CamilV/FEEG2001_QuadCopter/Code/Autopilot flight.png

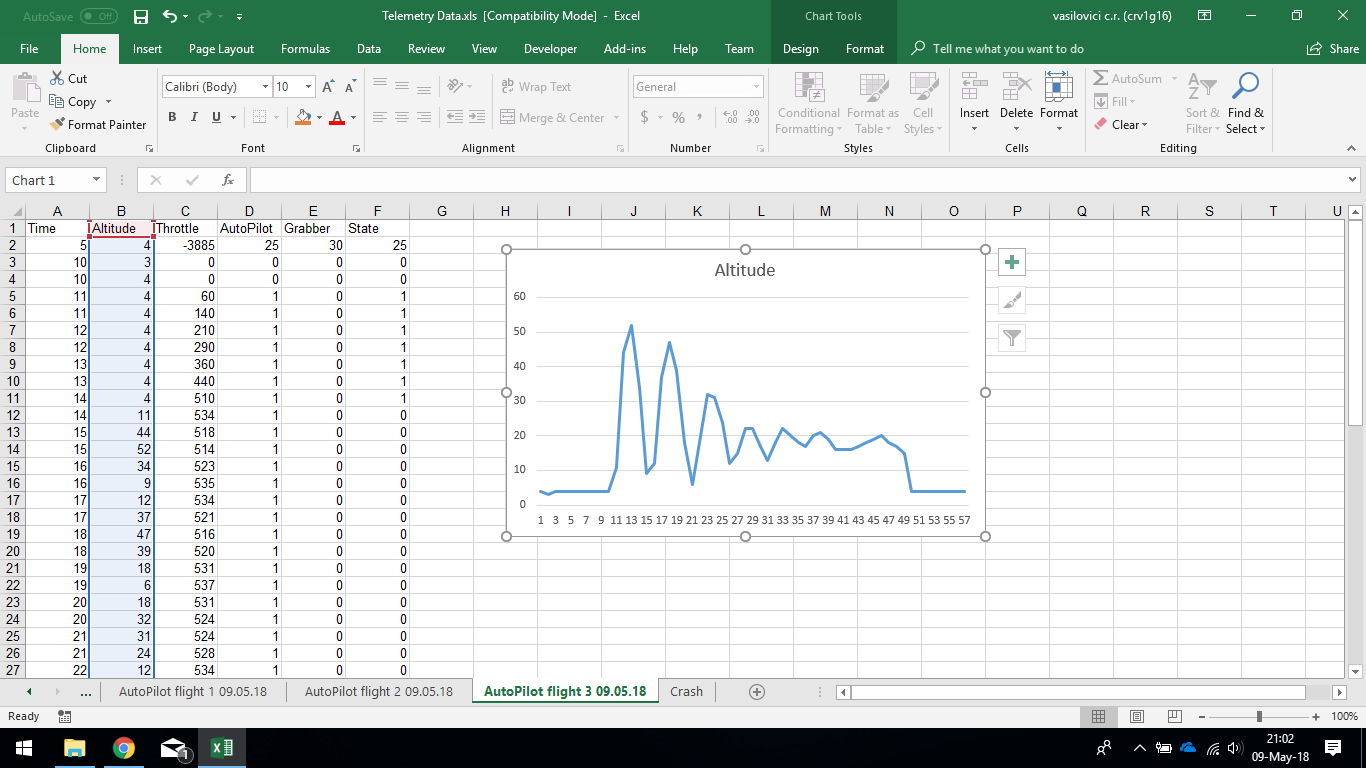
Code/Autopilot flight.png
