CamilV/FEEG2001_QuadCopter/Electronics/ArduinoBoard v3/base board v3_CopperStripes Board.jpg

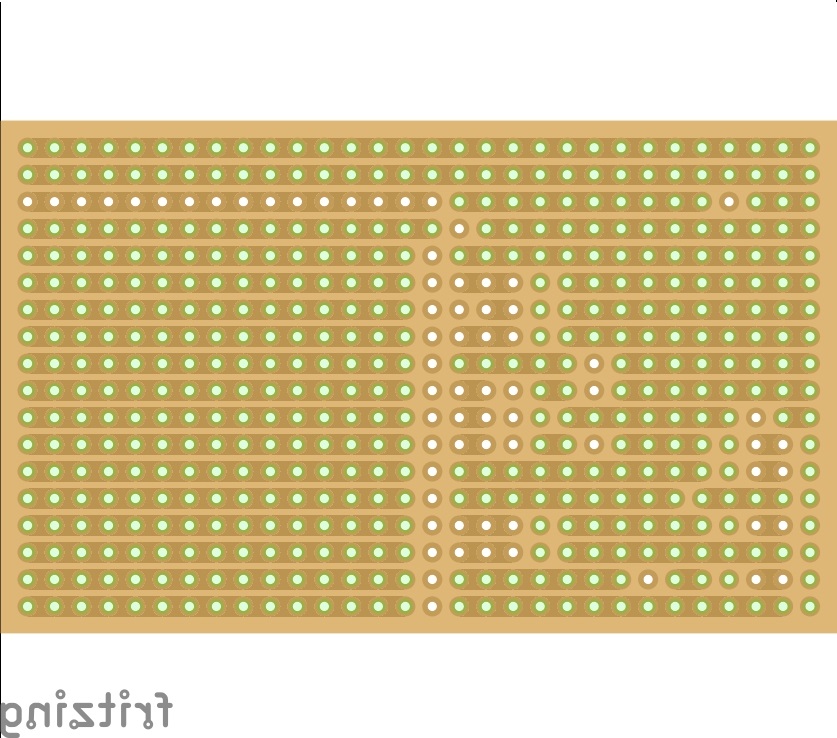
Electronics/ArduinoBoard v3/base board v3_CopperStripes Board.jpg
