CamilV/FEEG2001_QuadCopter/Report- Final/1.png

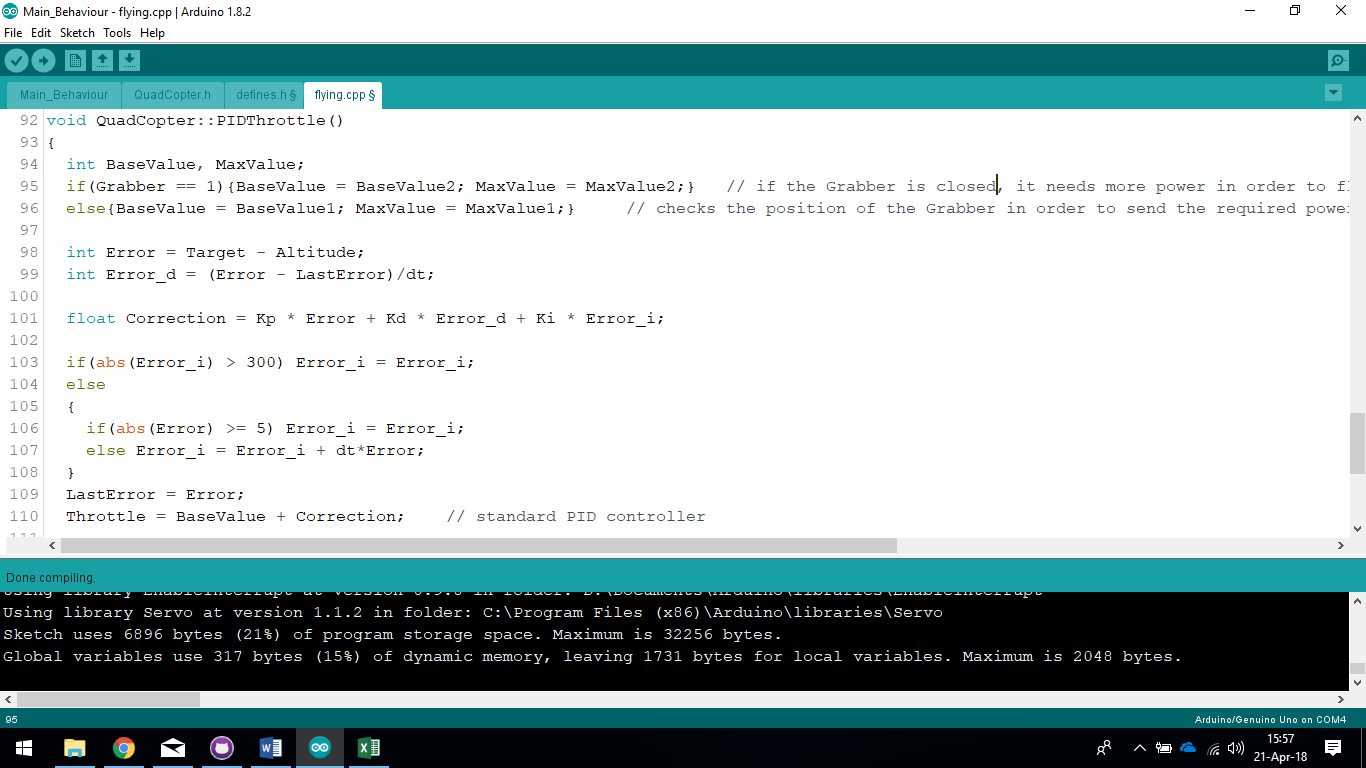
Report- Final/1.png
