CamilV/FEEG2001_QuadCopter/Report- Final/2.png

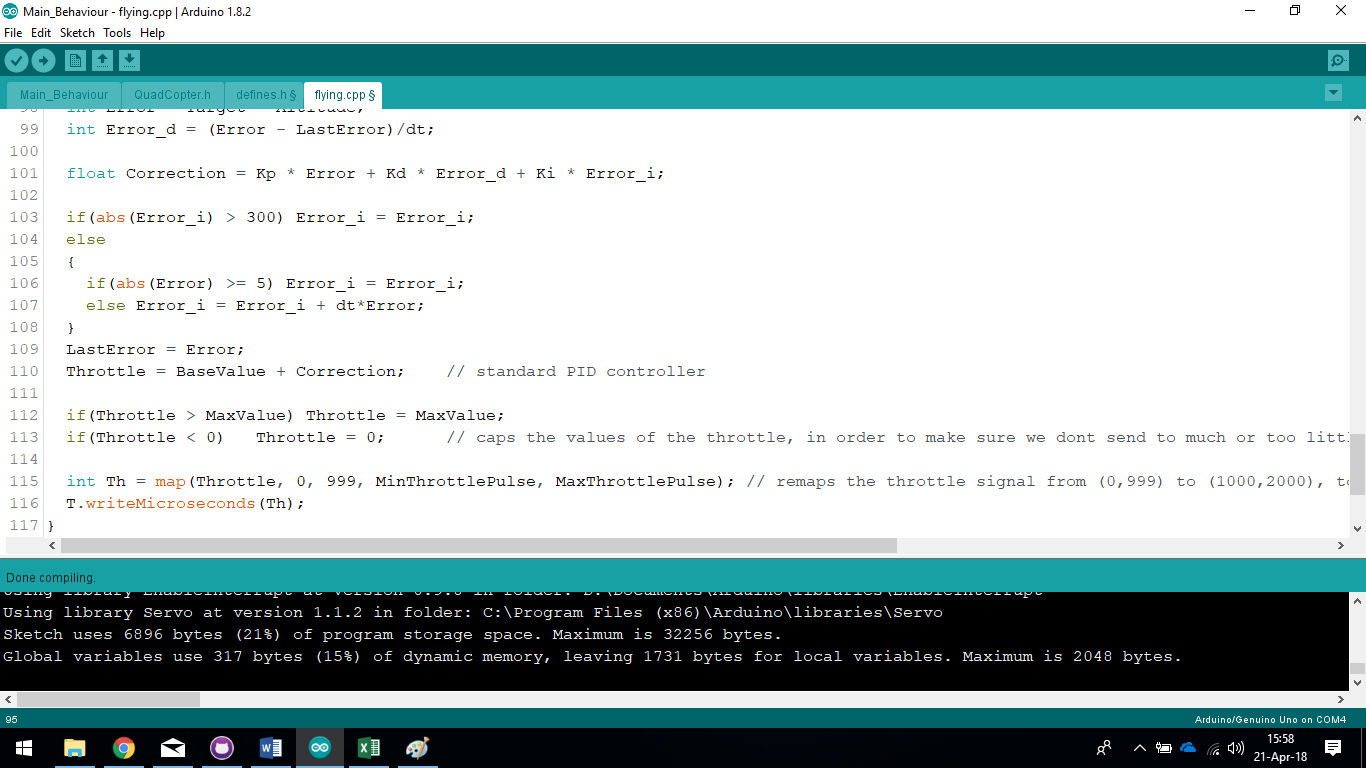
Report- Final/2.png
