CamilV/FEEG2001_QuadCopter/Report- Final/11.png

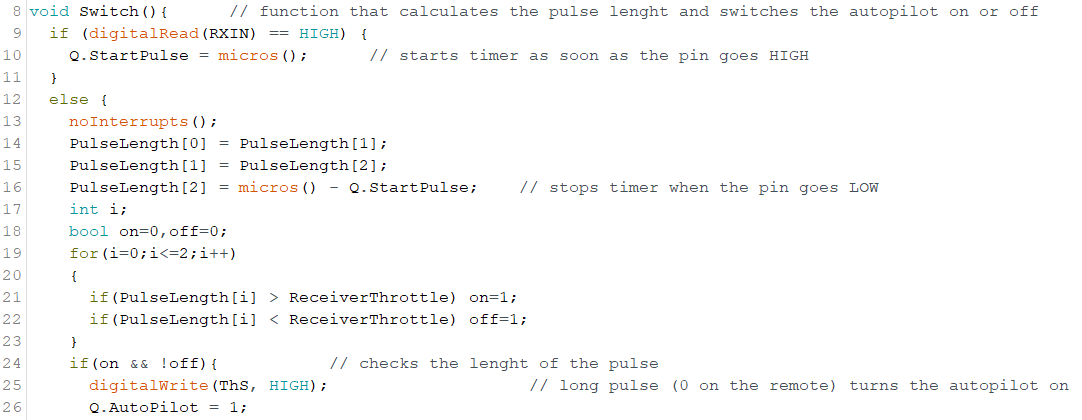
Report- Final/11.png
