CamilV/FEEG2001_QuadCopter/Report- Final/22.png

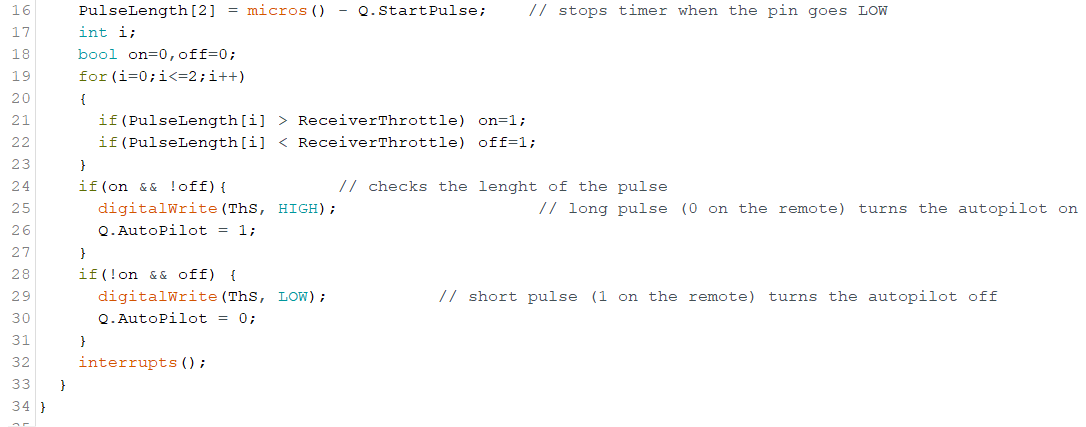
Report- Final/22.png
