CamilV/FEEG2001_QuadCopter/Report- Final/code 2.png

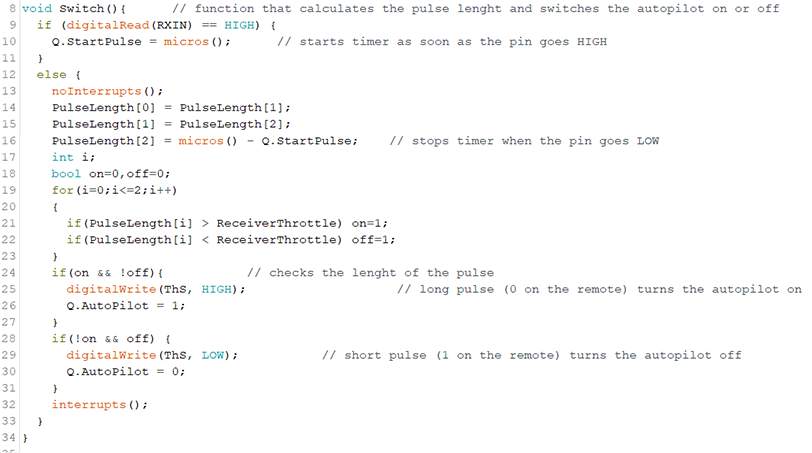
Report- Final/code 2.png
