CamilV/FEEG2001_QuadCopter/Report - Week 5/Mass quadcopter.ods

Component | Mass [Kg] | Number | Total mass [Kg] | Mass Constraint | Total
Main frame (mdf) | 0.0725 | 1 | 0.0725 | 0.75 | 0.6301
Arduino + shield | 0.0248 | 1 | 0.0248
Power distibution Board | 0.0122 | 1 | 0.0122
Flight controller board | 0.0081 | 1 | 0.0081
Battery | 0.168 | 1 | 0.168
Receiver | 0.005 | 1 | 0.005
Motor | 0.03 | 4 | 0.12
Propeller | 0.012 | 4 | 0.048
Speed controller | 0.007 | 4 | 0.028
Ultrasonic range finder | 0.015 | 1 | 0.015
Li-po bag | 0.075 | 1 | 0.075
Bullet connectors | 0.028 | 1 | 0.028
Servo | 0.0137 | 1 | 0.0137
M3 20mm Bolt | 1.3 |  | 0
M3 15mm Bolt | 1 |  | 0
10 x M3 Nut | 3.3 |  | 0
Landing Gear | 0.00095 | 4 | 0.0038
Hinges | 0.002 | 4 | 0.008
