CamilV/FEEG2001_QuadCopter/Solidworks Files/3 mm/Main Plate.SLDPRT

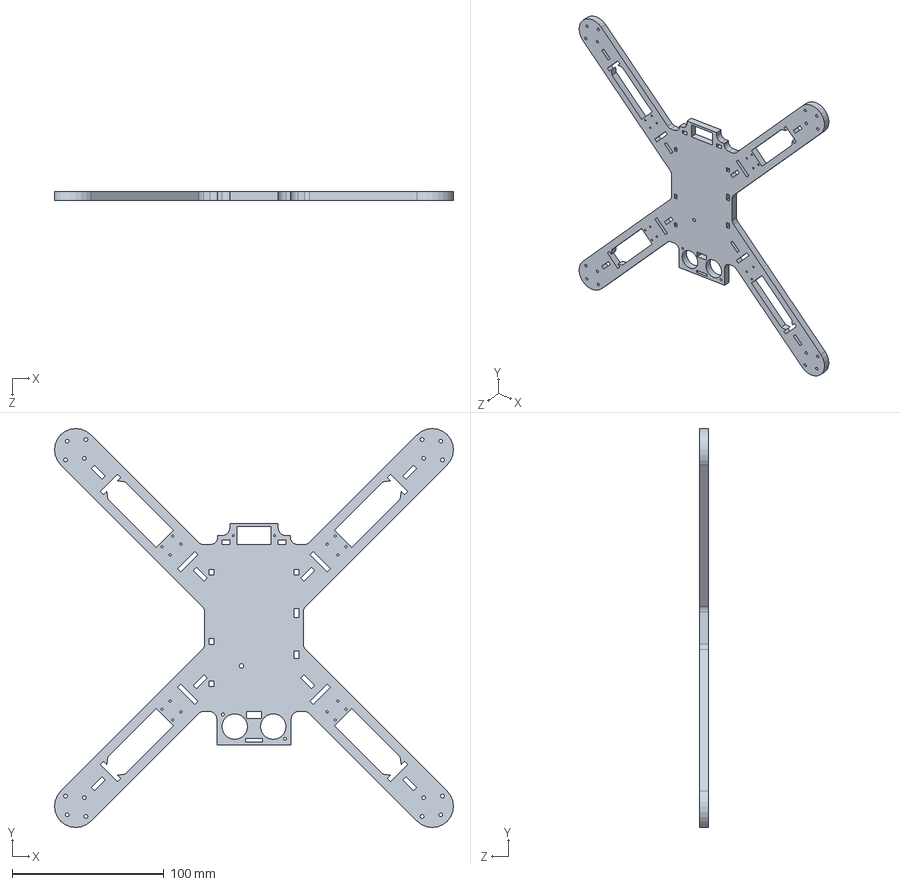
[picture p20: CAD file, 2018-05-09]
Solidworks Files/3 mm/Main Plate.SLDPRT
263.0 x 263.0 x 6.00 mm
