CamilV/FEEG2001_QuadCopter/Solidworks Files/3 mm/Servo Mini SG90/SG60 Servo.SLDASM

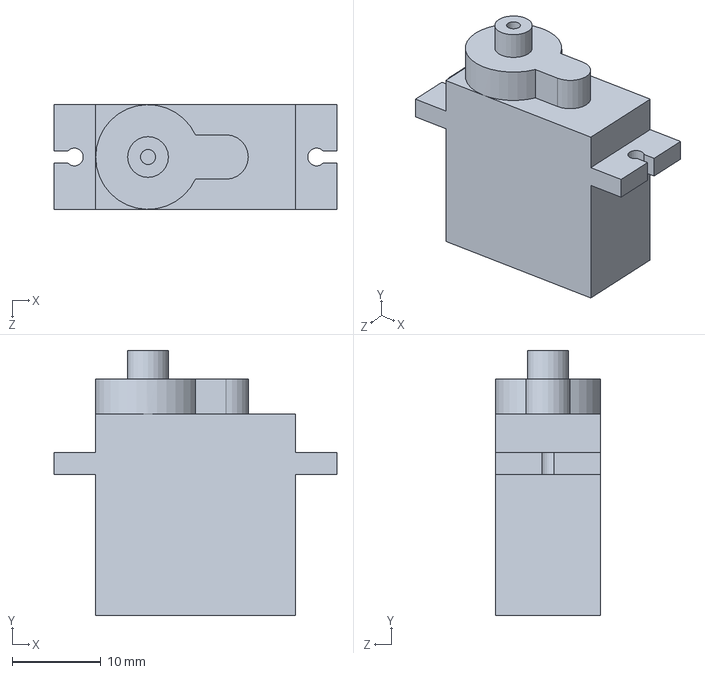
[picture p21: CAD file, 2018-02-15]
Solidworks Files/3 mm/Servo Mini SG90/SG60 Servo.SLDASM
31.9 x 29.9 x 11.8 mm
