CamilV/FEEG2001_QuadCopter/Solidworks Files/3 mm/Assem_Drone.SLDASM

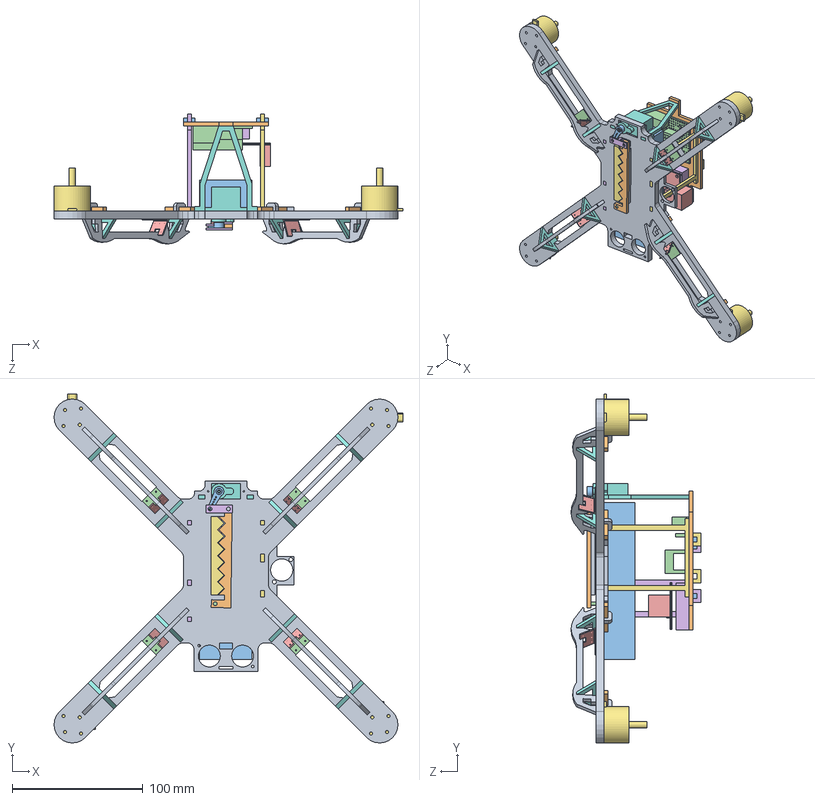
[picture p22: CAD file, 2018-05-09]
Solidworks Files/3 mm/Assem_Drone.SLDASM
266.9 x 266.9 x 99.2 mm
Main Plate
Secondary plate
Battery
arduino-and-shield (1)
PDB_MATEK
Naze32
DYS-SE2205 x 4
Servo
moving top
Moving Bottm
Horn Servo
Pivot
fixed top
Coupler - Copy
fixed bottom
triangular strut x 8
under-strut v2 x 4
pin x 8
pin short x 3
Copy of Part3 x 4
Long Side
Short Side
Back Side
max support
