CamilV/FEEG2001_QuadCopter/Main Plate.SLDPRT

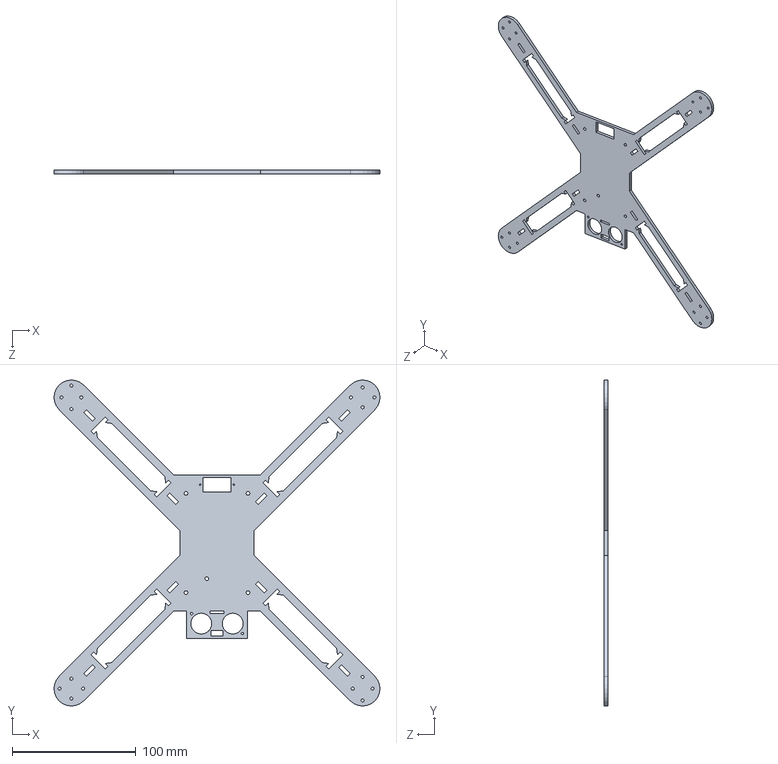
[picture p23: CAD file, 2018-02-19]
Main Plate.SLDPRT
263.0 x 263.0 x 3.00 mm
