CamilV/FEEG2001_QuadCopter/Solidworks Files/final cut/Main Plate.DXF

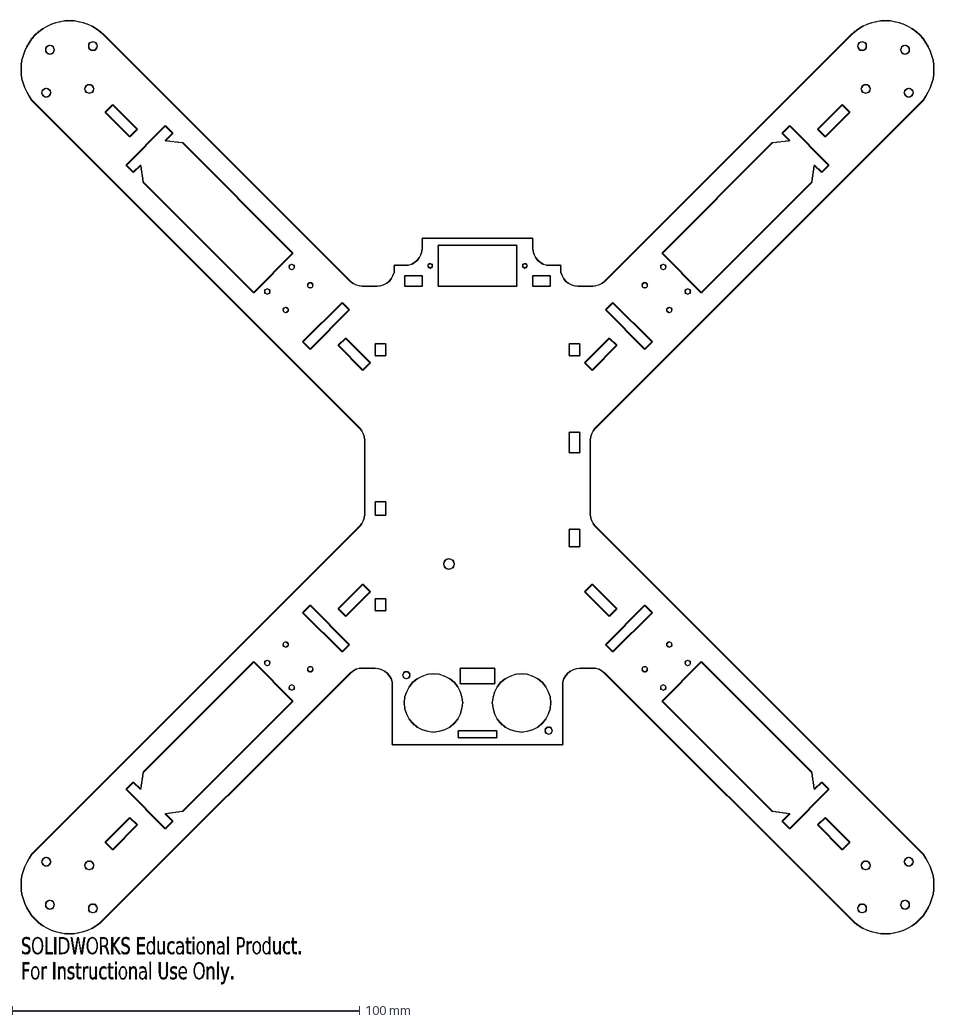
[picture p24: CAD file, 2018-05-09]
Solidworks Files/final cut/Main Plate.DXF
SOLIDWORKS Educational Product.
For Instructional Use Only.
