CamilV/FEEG2001_QuadCopter/SolidWorks Models/Grabber/Assem1.SLDASM

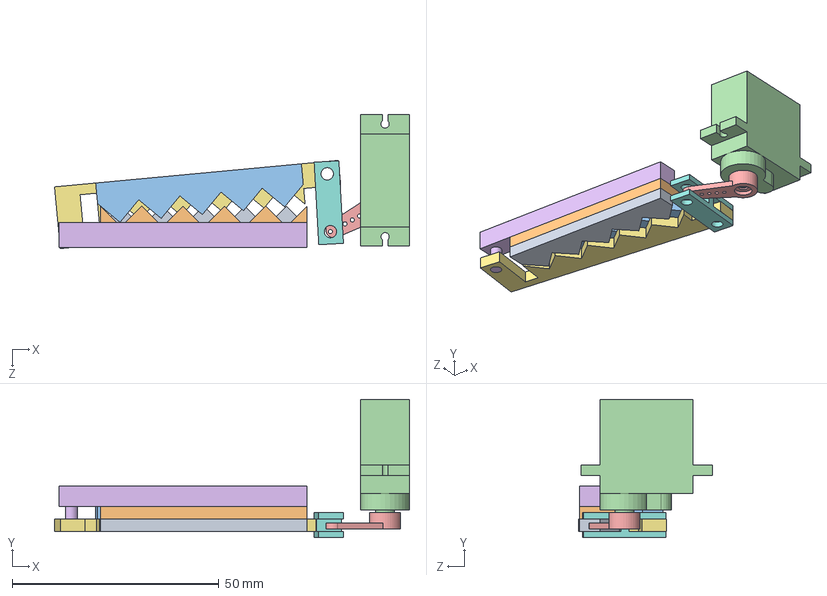
[picture p25: CAD file, 2018-02-12]
SolidWorks Models/Grabber/Assem1.SLDASM
85.9 x 33.4 x 32.5 mm
fixed bottom
fixed top
moving top
Servo
Horn Servo
holder(just so the mates can exist)
Moving Bottm
Coupler
