CamilV/FEEG2001_QuadCopter/Solidworks Files/4.5 mm/Main Plate.SLDPRT

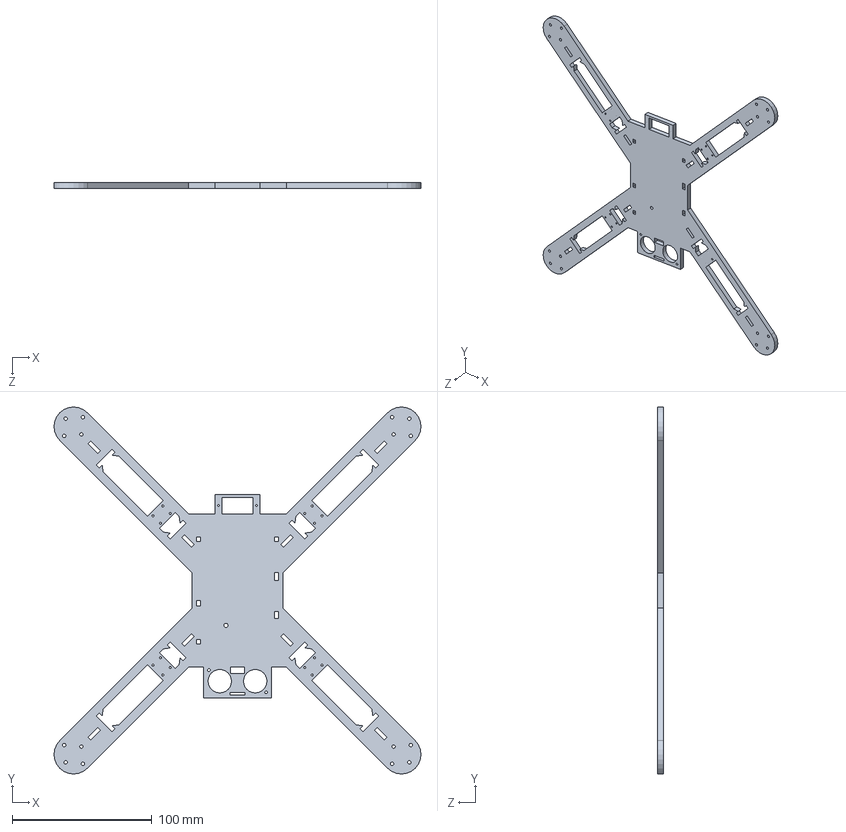
[picture p26: CAD file, 2018-03-05]
Solidworks Files/4.5 mm/Main Plate.SLDPRT
263.0 x 263.0 x 4.50 mm
