CamilV/FEEG2001_QuadCopter/Solidworks Files/3 mm/SolidWorks Models/Naze32.SLDPRT

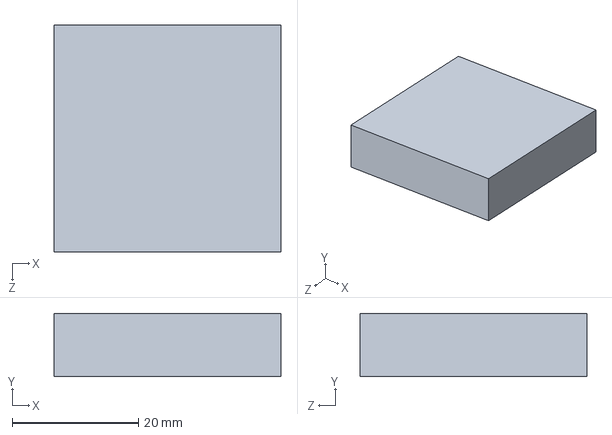
[picture p27: CAD file, 2018-02-15]
Solidworks Files/3 mm/SolidWorks Models/Naze32.SLDPRT
36.0 x 10.0 x 36.0 mm
