CamilV/FEEG2001_QuadCopter/Solidworks Files/final cut/Back Side.DXF

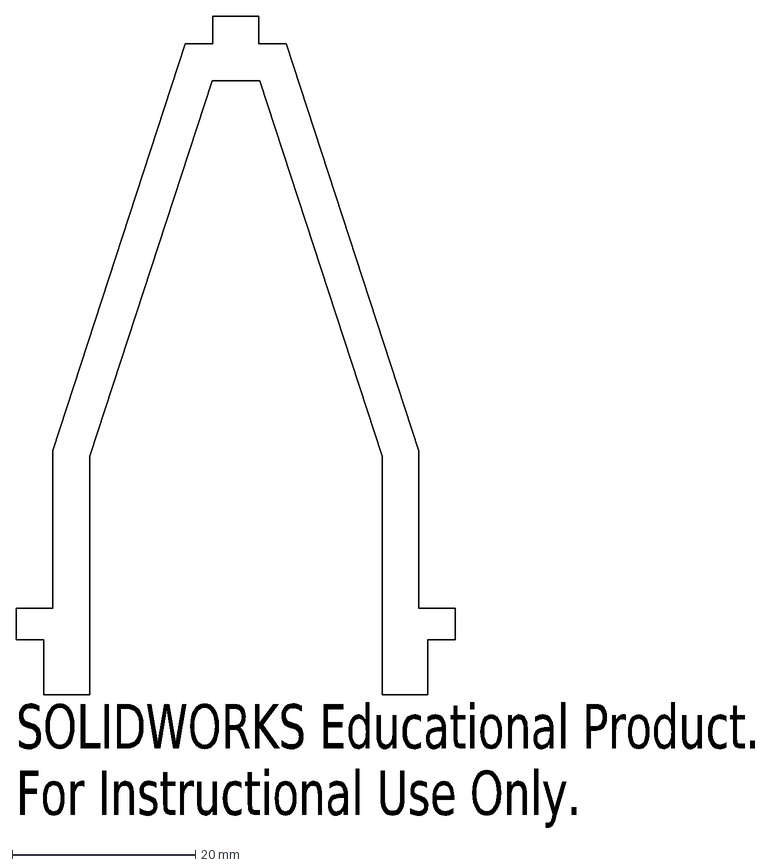
[picture p29: CAD file, 2018-05-09]
Solidworks Files/final cut/Back Side.DXF
SOLIDWORKS Educational Product.
For Instructional Use Only.
