CamilV/FEEG2001_QuadCopter/SolidWorks Models/Coupler-Copy.sldprt

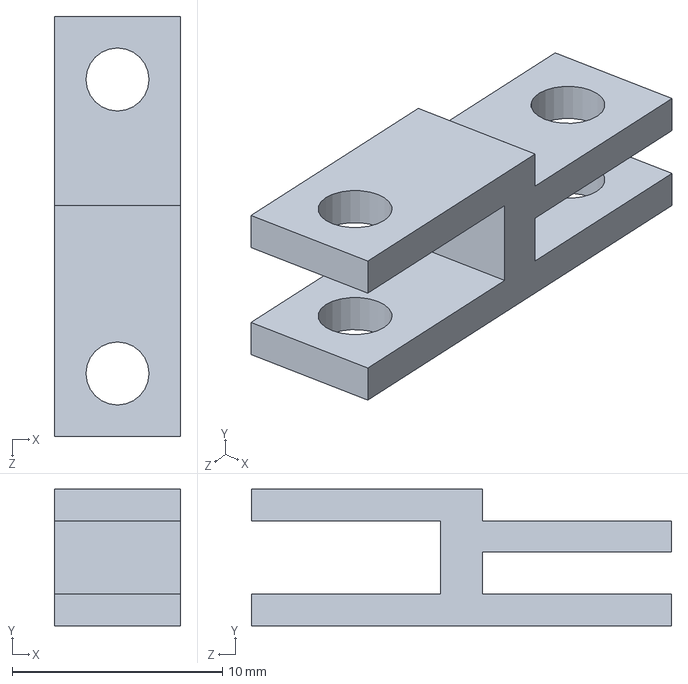
[picture p30: CAD file, 2018-02-14]
SolidWorks Models/Coupler-Copy.sldprt
6.00 x 6.50 x 20.0 mm
