CamilV/FEEG2001_QuadCopter/under-strut v2.sldprt

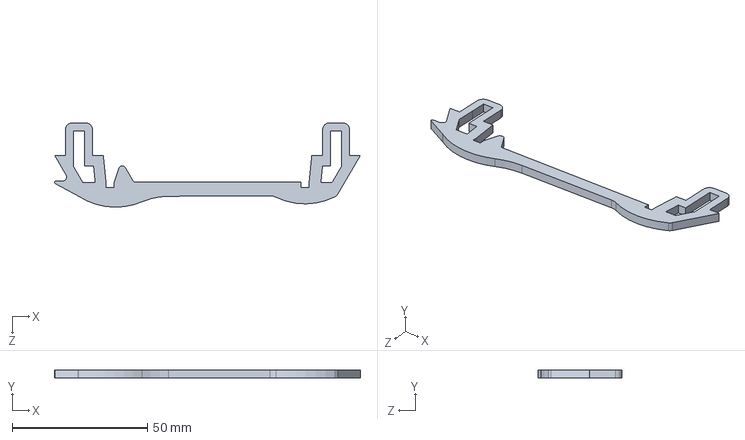
[picture p31: CAD file, 2018-05-06]
under-strut v2.sldprt
113.0 x 3.00 x 31.2 mm
