CamilV/FEEG2001_QuadCopter/Solidworks Files/3 mm/SolidWorks Models/Arduino Uno.SLDPRT

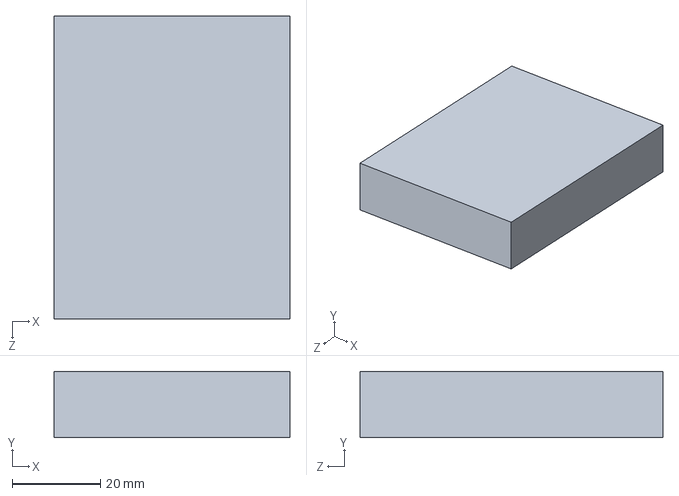
[picture p32: CAD file, 2018-02-15]
Solidworks Files/3 mm/SolidWorks Models/Arduino Uno.SLDPRT
53.4 x 15.0 x 68.6 mm
