CamilV/FEEG2001_QuadCopter/Solidworks Files/4.5 mm/SolidWorks Models/AfroESC 30.SLDPRT

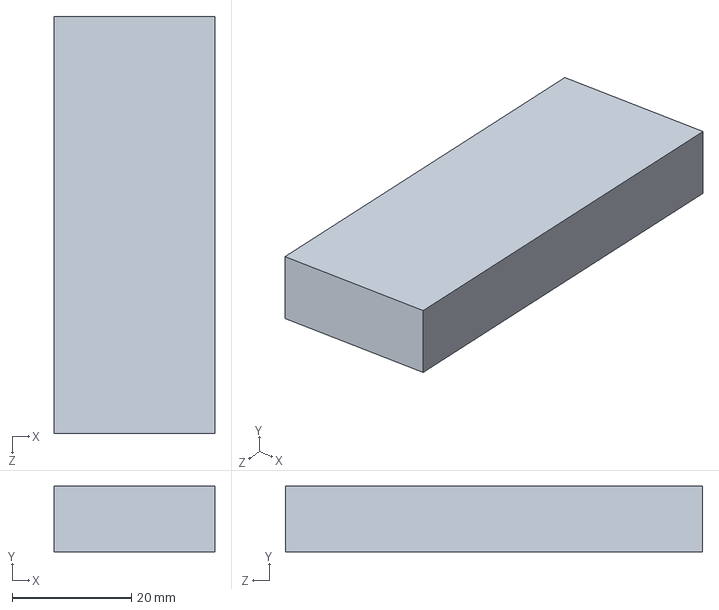
[picture p33: CAD file, 2018-02-15]
Solidworks Files/4.5 mm/SolidWorks Models/AfroESC 30.SLDPRT
27.0 x 11.0 x 70.0 mm
