CamilV/FEEG2001_QuadCopter/Solidworks Files/4.5 mm/under strut.sldprt

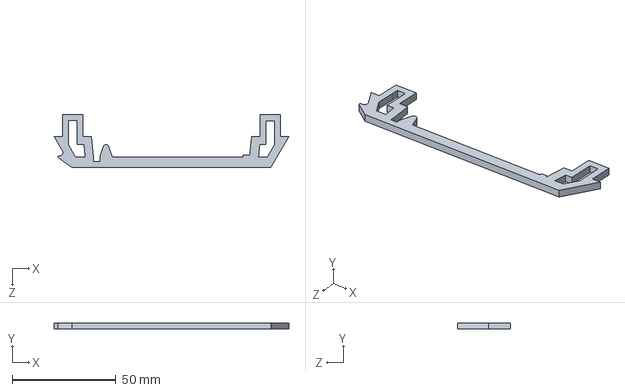
[picture p34: CAD file, 2018-03-05]
Solidworks Files/4.5 mm/under strut.sldprt
113.0 x 3.00 x 25.5 mm
