CamilV/FEEG2001_QuadCopter/Solidworks Files/final cut/max support.DXF

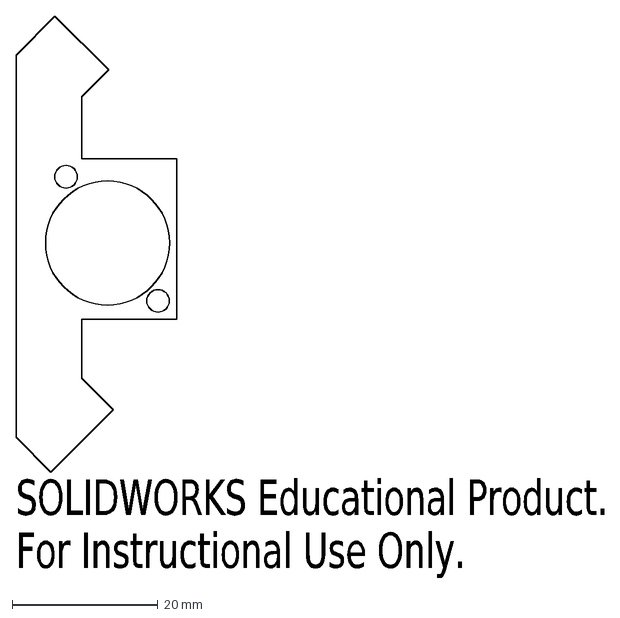
[picture p35: CAD file, 2018-05-09]
Solidworks Files/final cut/max support.DXF
SOLIDWORKS Educational Product.
For Instructional Use Only.
