CamilV/FEEG2001_QuadCopter/Solidworks Files/3 mm/Servo Mini SG90/Horn Servo.SLDPRT

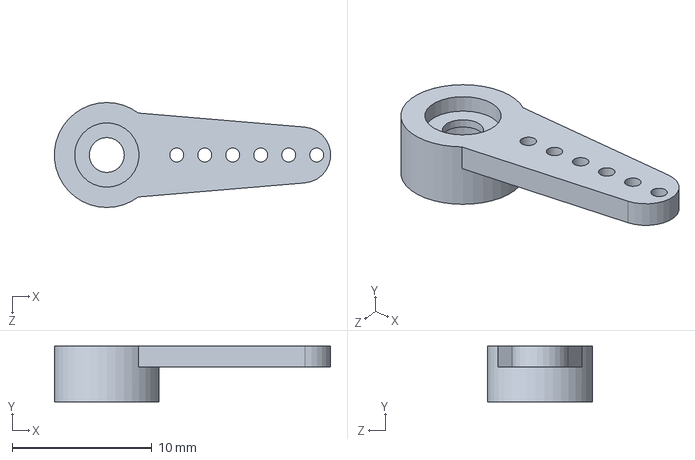
[picture p36: CAD file, 2018-02-12]
Solidworks Files/3 mm/Servo Mini SG90/Horn Servo.SLDPRT
19.7 x 4.00 x 7.50 mm
