CamilV/FEEG2001_QuadCopter/Solidworks Files/3 mm/Short Side.sldprt

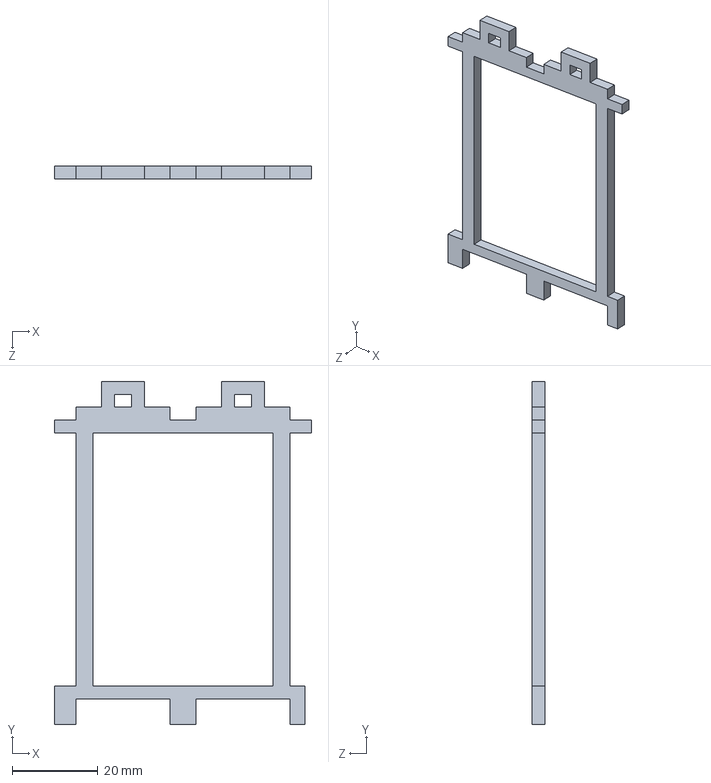
[picture p37: CAD file, 2018-05-06]
Solidworks Files/3 mm/Short Side.sldprt
60.0 x 80.0 x 3.00 mm
