CamilV/FEEG2001_QuadCopter/SolidWorks Models/Secondary-plate.SLDPRT

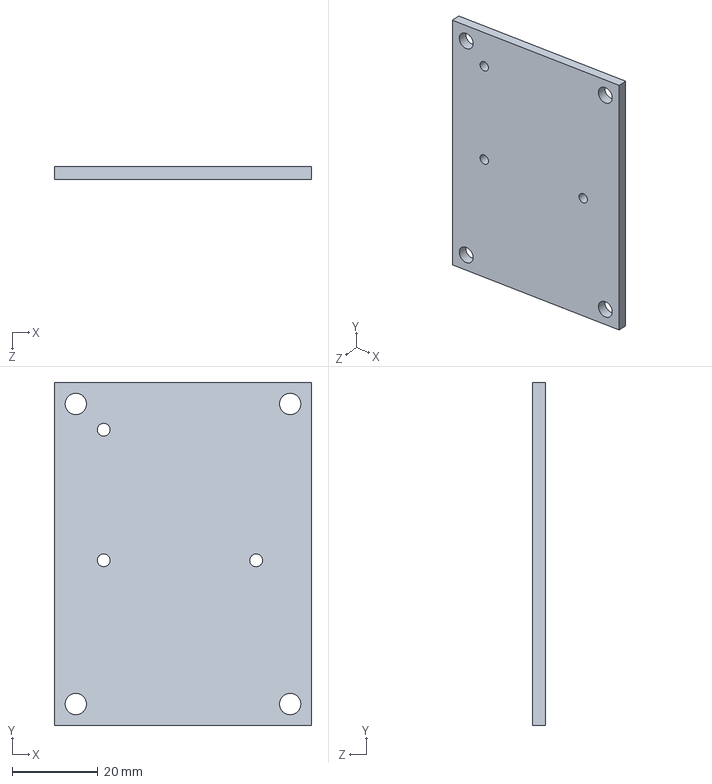
[picture p38: CAD file, 2018-02-10]
SolidWorks Models/Secondary-plate.SLDPRT
60.0 x 80.0 x 3.00 mm
