CamilV/FEEG2001_QuadCopter/Solidworks Files/3 mm/Back Side.sldprt

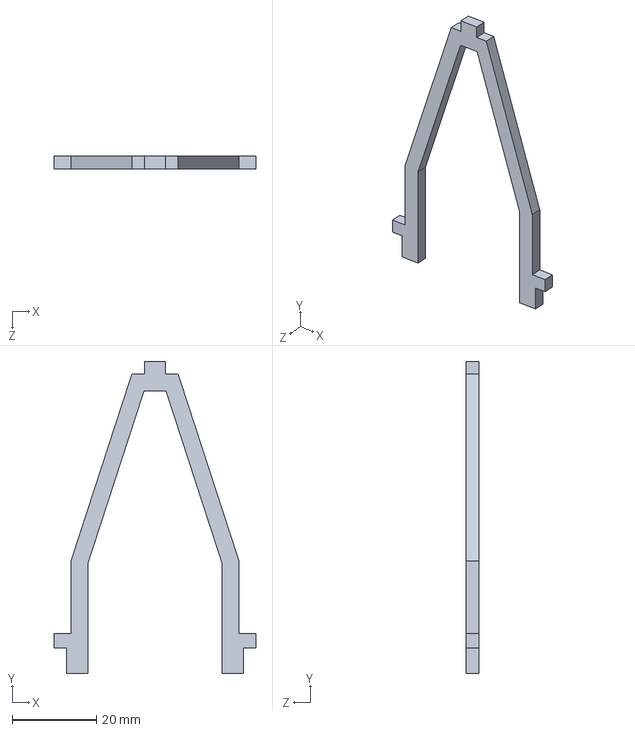
[picture p39: CAD file, 2018-05-06]
Solidworks Files/3 mm/Back Side.sldprt
47.9 x 74.0 x 3.00 mm
