CamilV/FEEG2001_QuadCopter/Solidworks Files/4.5 mm/Short Side.sldprt

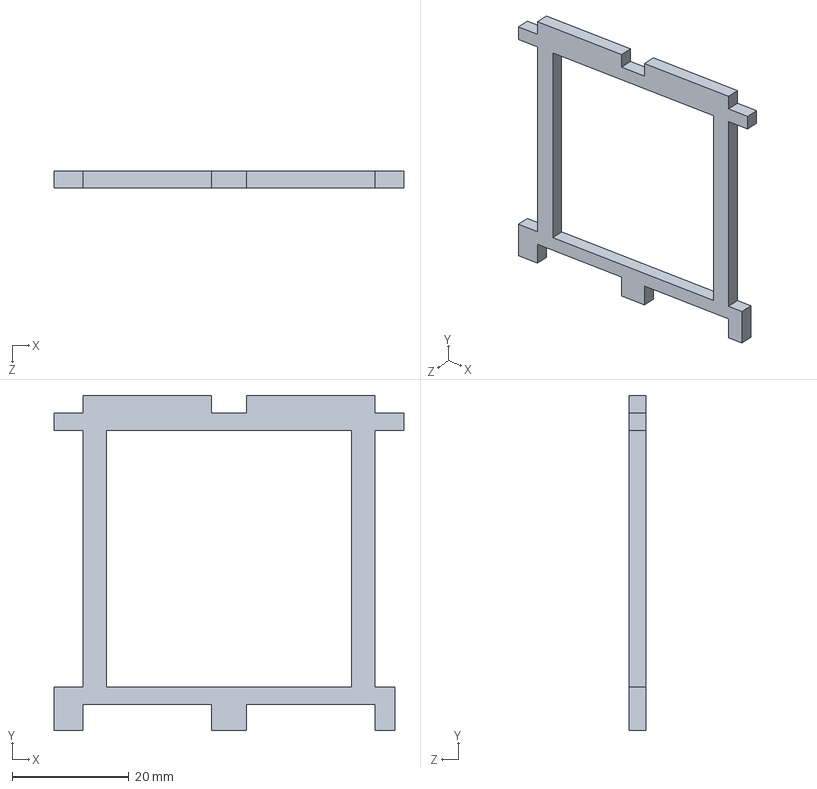
[picture p40: CAD file, 2018-03-05]
Solidworks Files/4.5 mm/Short Side.sldprt
60.0 x 57.5 x 3.00 mm
