CamilV/FEEG2001_QuadCopter/Solidworks Files/final cut/triangular strut.DXF

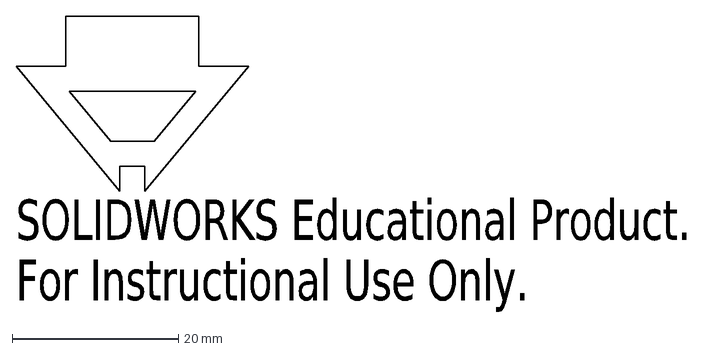
[picture p41: CAD file, 2018-05-09]
Solidworks Files/final cut/triangular strut.DXF
SOLIDWORKS Educational Product.
For Instructional Use Only.
