CamilV/FEEG2001_QuadCopter/SolidWorks Models/DRONE-LOL.SLDPRT

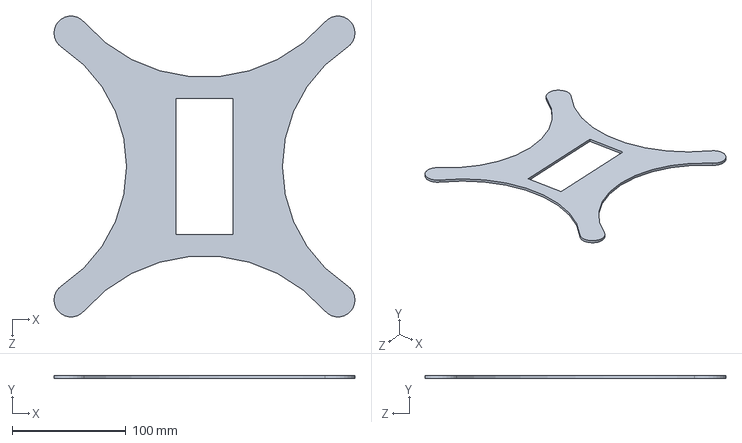
[picture p42: CAD file, 2018-02-08]
SolidWorks Models/DRONE-LOL.SLDPRT
265.0 x 3.00 x 264.8 mm
