CamilV/FEEG2001_QuadCopter/Solidworks Files/3 mm/Long Side.sldprt

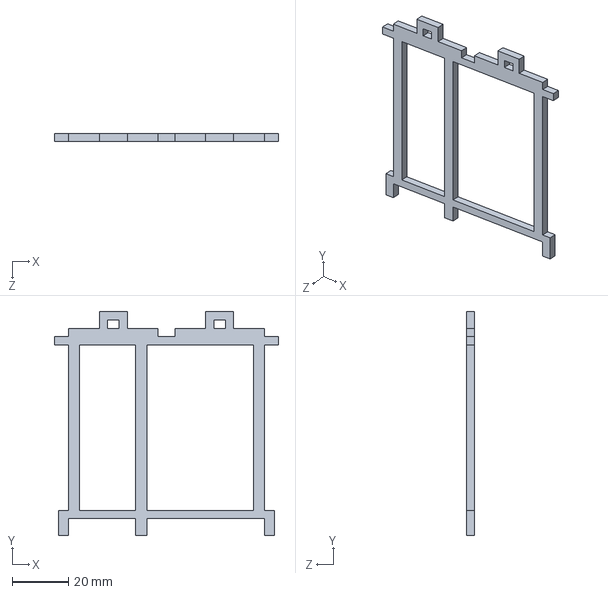
[picture p43: CAD file, 2018-05-06]
Solidworks Files/3 mm/Long Side.sldprt
80.0 x 80.0 x 3.00 mm
