CamilV/FEEG2001_QuadCopter/Solidworks Files/4.5 mm/triangular strut.sldprt

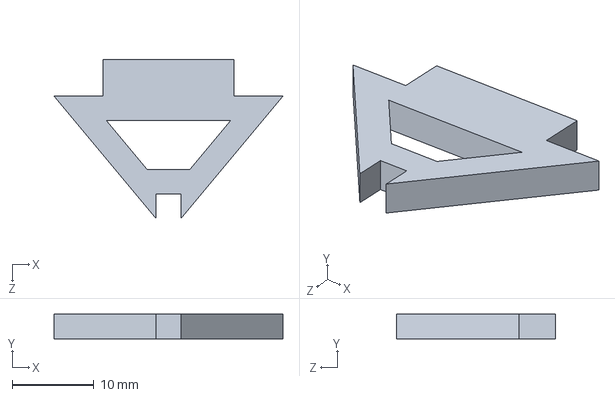
[picture p44: CAD file, 2018-03-05]
Solidworks Files/4.5 mm/triangular strut.sldprt
28.0 x 3.00 x 19.5 mm
