CamilV/FEEG2001_QuadCopter/Solidworks Files/final cut/Short Side.DXF

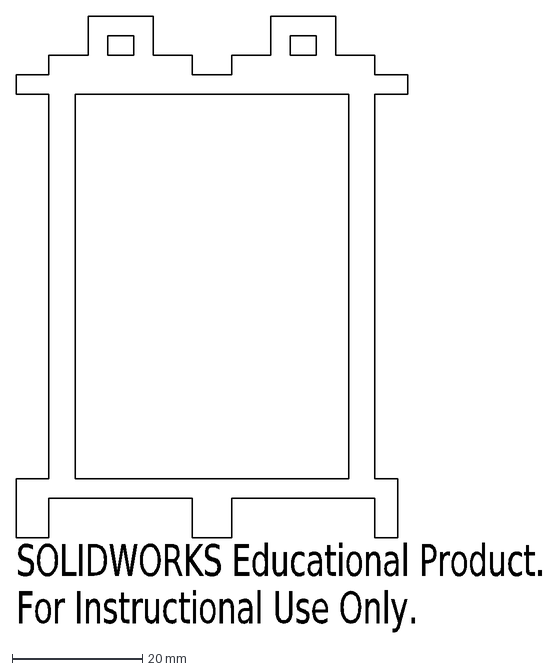
[picture p45: CAD file, 2018-05-09]
Solidworks Files/final cut/Short Side.DXF
SOLIDWORKS Educational Product.
For Instructional Use Only.
