CamilV/FEEG2001_QuadCopter/SolidWorks Models/arduino and shield.SLDPRT

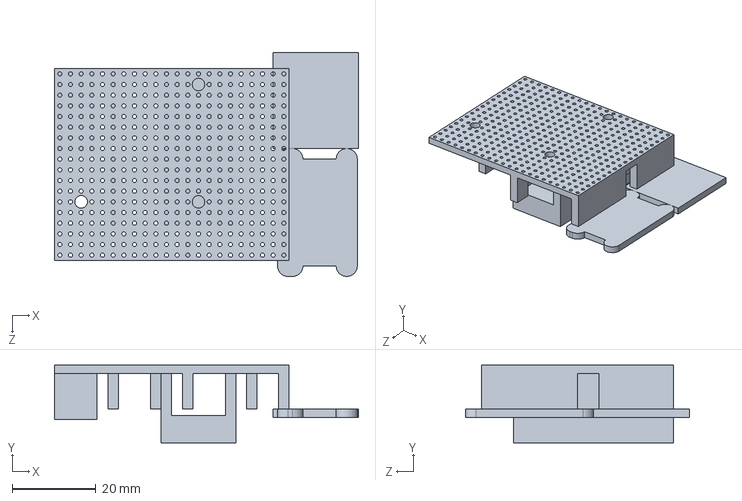
[picture p46: CAD file, 2018-02-08]
SolidWorks Models/arduino and shield.SLDPRT
72.4 x 18.5 x 53.3 mm
