CamilV/FEEG2001_QuadCopter/Solidworks Files/3 mm/triangular strut.sldprt

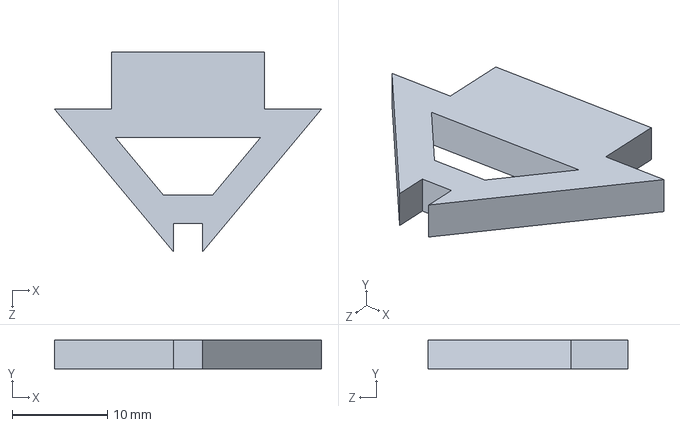
[picture p47: CAD file, 2018-05-06]
Solidworks Files/3 mm/triangular strut.sldprt
28.0 x 3.00 x 21.0 mm
