CamilV/FEEG2001_QuadCopter/Solidworks Files/4.5 mm/Secondary plate.SLDPRT

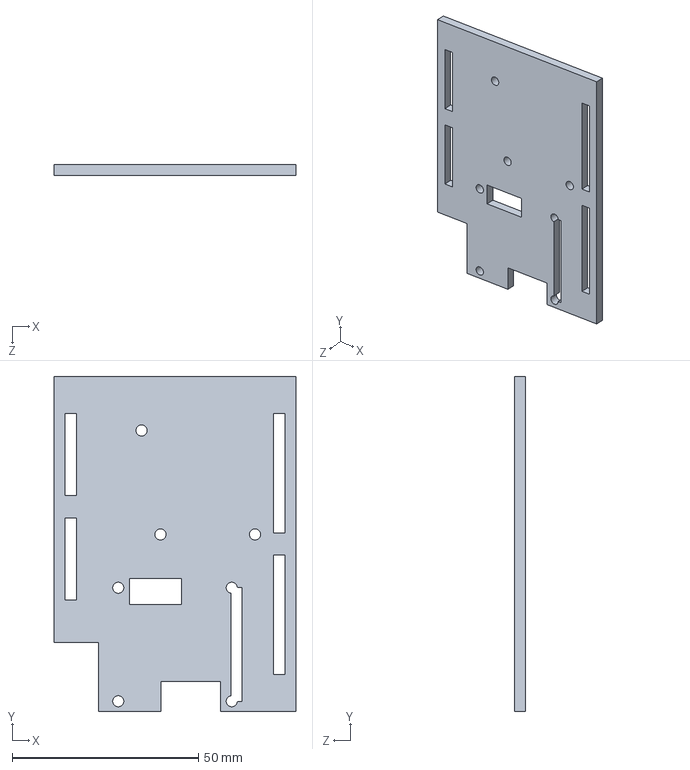
[picture p48: CAD file, 2018-03-05]
Solidworks Files/4.5 mm/Secondary plate.SLDPRT
65.0 x 90.0 x 3.00 mm
