CamilV/FEEG2001_QuadCopter/Solidworks Files/final cut/Long Side.DXF

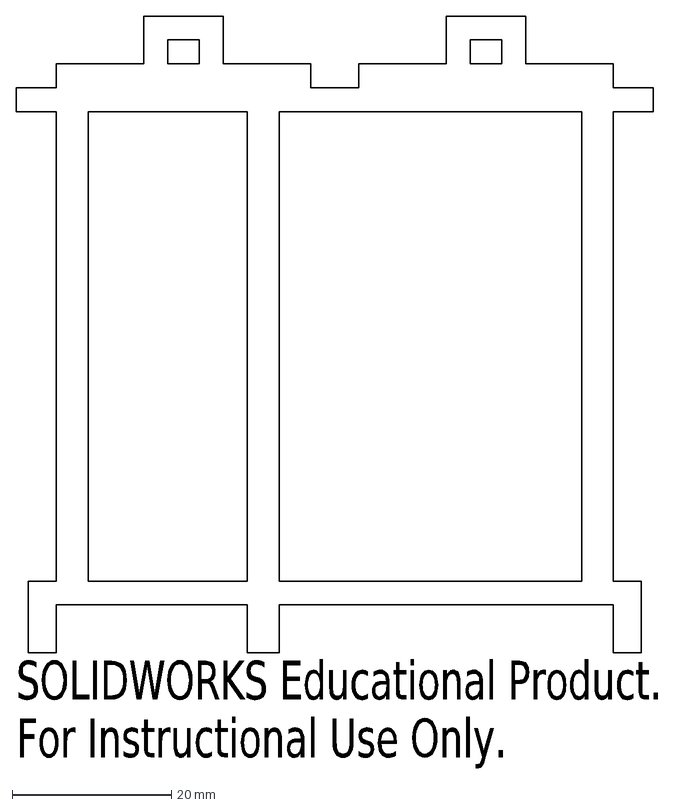
[picture p49: CAD file, 2018-05-09]
Solidworks Files/final cut/Long Side.DXF
SOLIDWORKS Educational Product.
For Instructional Use Only.
