CamilV/FEEG2001_QuadCopter/Solidworks Files/3 mm/under strut.sldprt

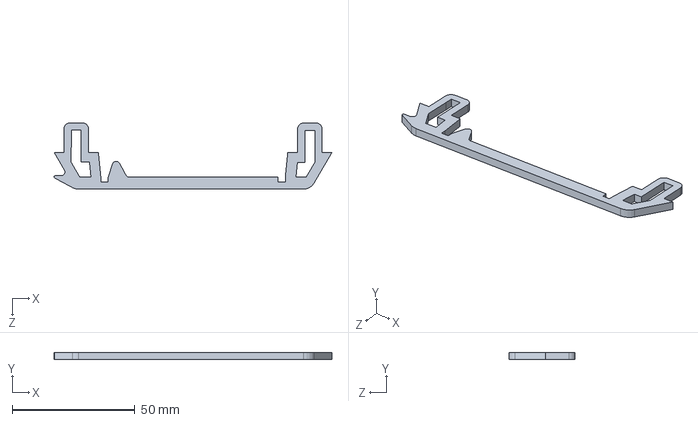
[picture p50: CAD file, 2018-05-06]
Solidworks Files/3 mm/under strut.sldprt
113.0 x 3.00 x 27.0 mm
