CamilV/FEEG2001_QuadCopter/Solidworks Files/final cut/under-strut v2.DXF

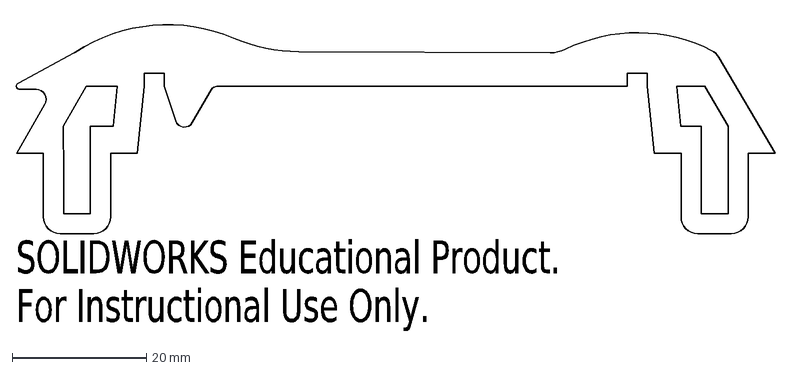
[picture p51: CAD file, 2018-05-09]
Solidworks Files/final cut/under-strut v2.DXF
SOLIDWORKS Educational Product.
For Instructional Use Only.
