CamilV/FEEG2001_QuadCopter/SolidWorks Models/DYS SE2205.SLDPRT

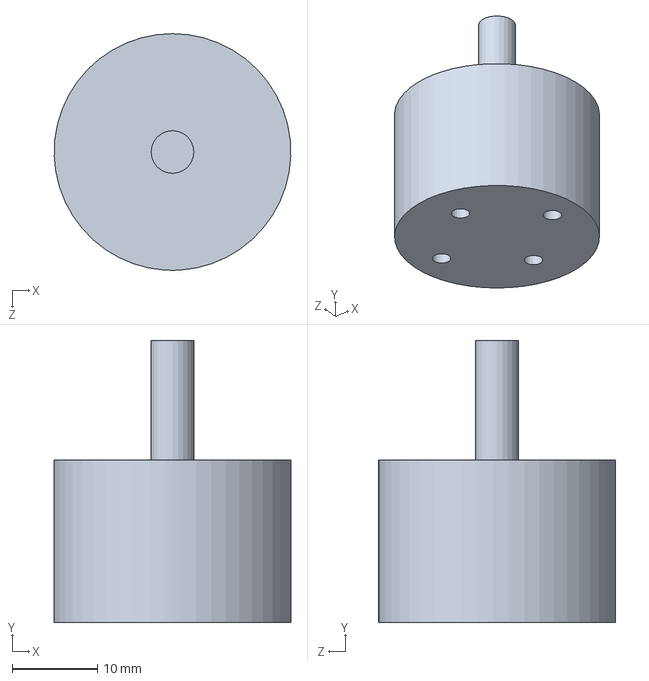
[picture p52: CAD file, 2018-02-07]
SolidWorks Models/DYS SE2205.SLDPRT
27.7 x 33.0 x 27.7 mm
