CamilV/FEEG2001_QuadCopter/Solidworks Files/3 mm/max support.sldprt

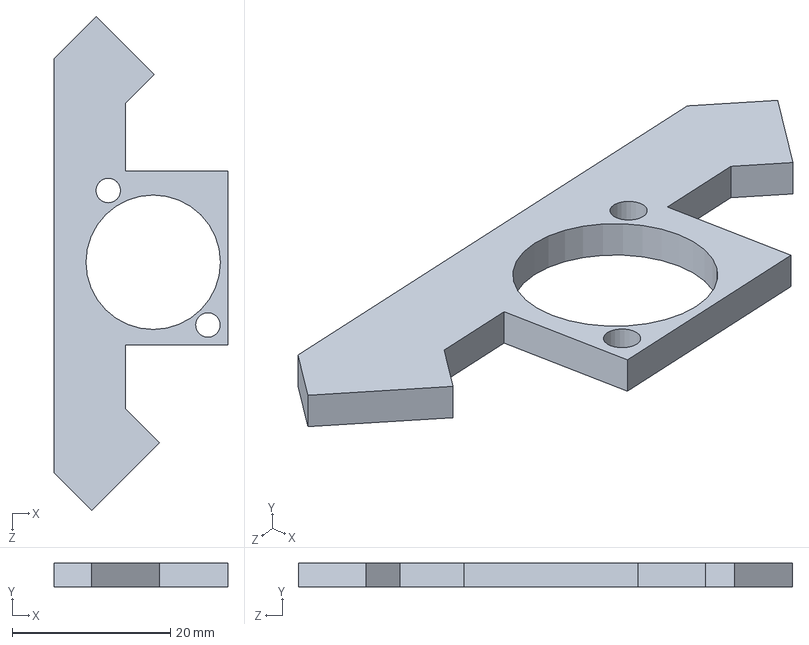
[picture p53: CAD file, 2018-05-06]
Solidworks Files/3 mm/max support.sldprt
22.0 x 3.00 x 62.5 mm
