CamilV/FEEG2001_QuadCopter/Solidworks Files/4.5 mm/moving top.sldprt

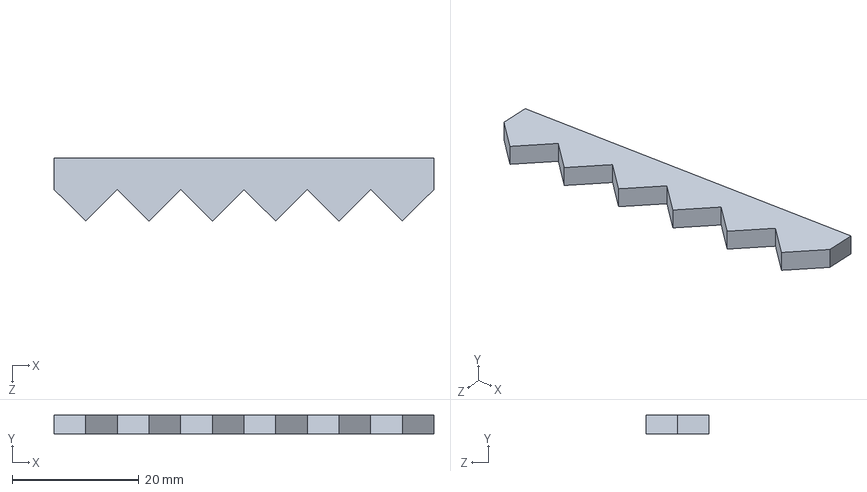
[picture p54: CAD file, 2018-03-05]
Solidworks Files/4.5 mm/moving top.sldprt
60.0 x 3.00 x 10.00 mm
