CamilV/FEEG2001_QuadCopter/Solidworks Files/3 mm/pin short.sldprt

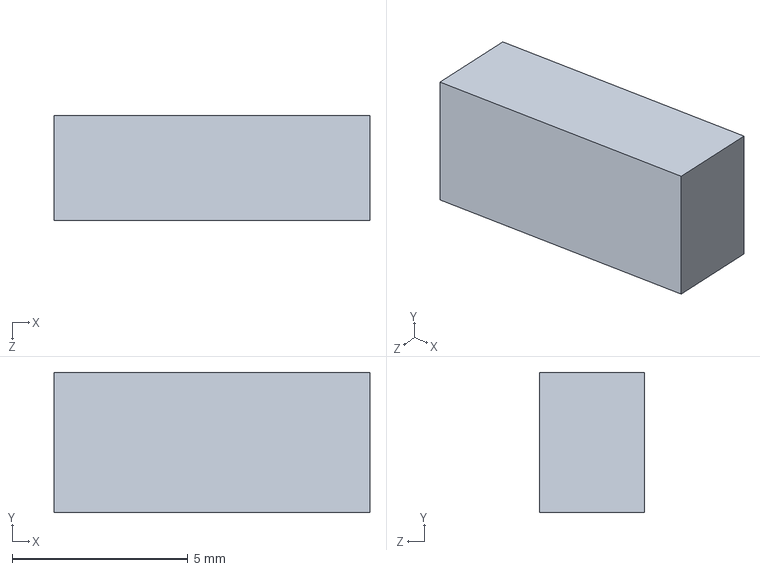
[picture p55: CAD file, 2018-03-08]
Solidworks Files/3 mm/pin short.sldprt
9.00 x 4.00 x 3.00 mm
