CamilV/FEEG2001_QuadCopter/Solidworks Files/4.5 mm/Moving Bottm.sldprt

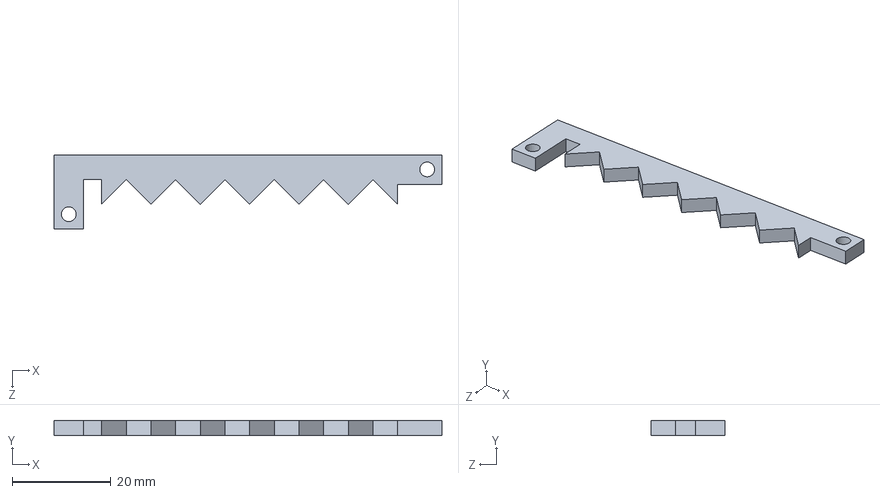
[picture p56: CAD file, 2018-03-05]
Solidworks Files/4.5 mm/Moving Bottm.sldprt
78.7 x 3.00 x 15.0 mm
