CamilV/FEEG2001_QuadCopter/Solidworks Files/3 mm/Secondary plate.SLDPRT

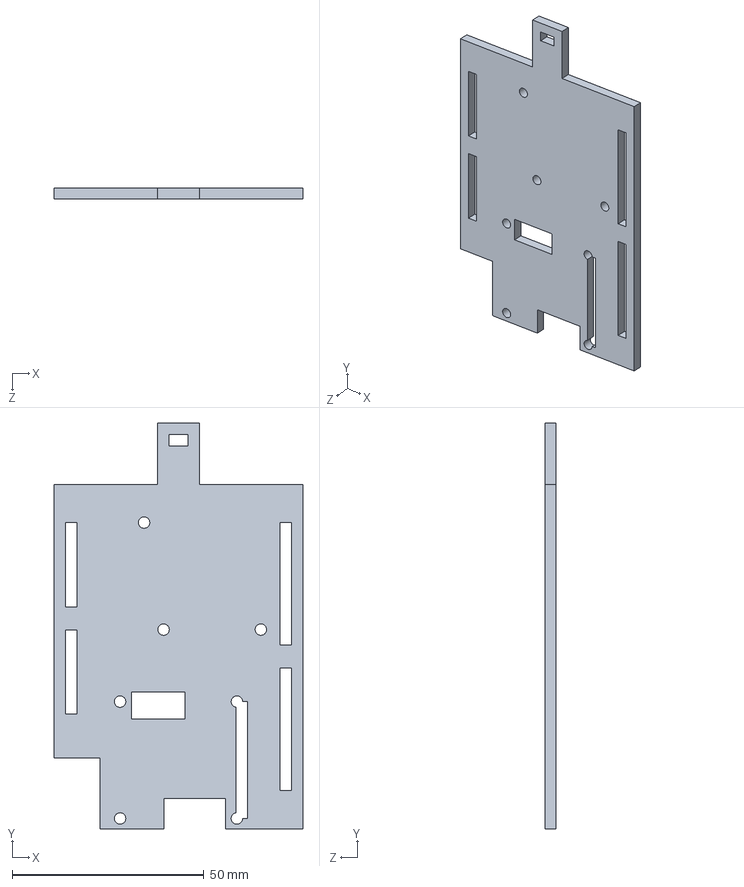
[picture p57: CAD file, 2018-03-08]
Solidworks Files/3 mm/Secondary plate.SLDPRT
65.0 x 106.0 x 3.00 mm
