CamilV/FEEG2001_QuadCopter/Solidworks Files/4.5 mm/Part3.sldprt

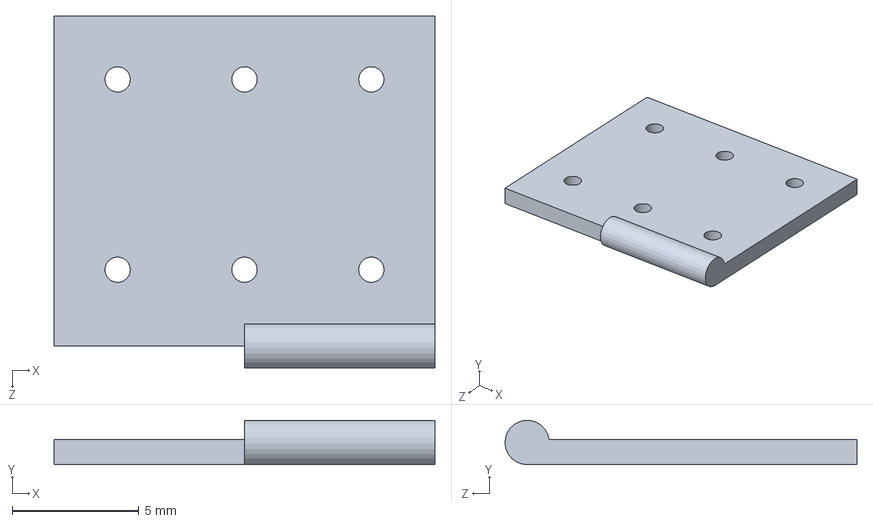
[picture p58: CAD file, 2018-03-03]
Solidworks Files/4.5 mm/Part3.sldprt
15.0 x 1.75 x 13.9 mm
