CamilV/FEEG2001_QuadCopter/Solidworks Files/4.5 mm/Part4.sldprt

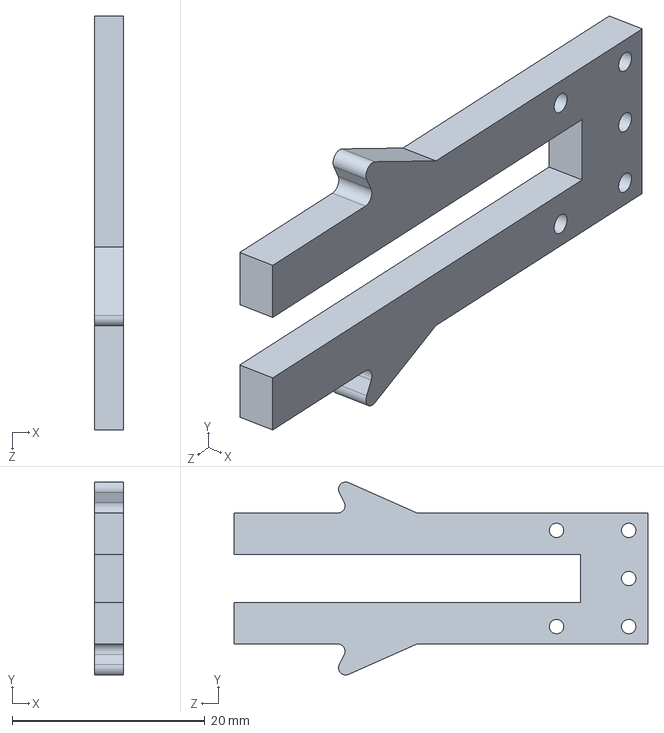
[picture p60: CAD file, 2018-03-03]
Solidworks Files/4.5 mm/Part4.sldprt
3.00 x 20.0 x 43.0 mm
