CamilV/FEEG2001_QuadCopter/Solidworks Files/4.5 mm/DYS-SE2205.SLDPRT

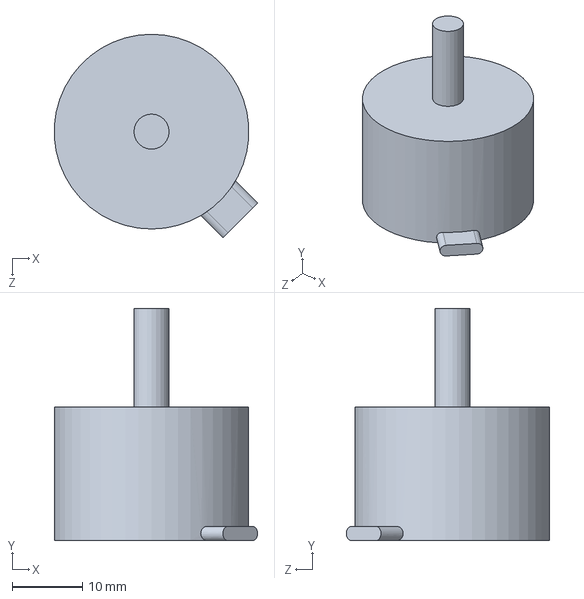
[picture p61: CAD file, 2018-02-21]
Solidworks Files/4.5 mm/DYS-SE2205.SLDPRT
28.9 x 33.0 x 28.9 mm
