CamilV/FEEG2001_QuadCopter/Solidworks Files/4.5 mm/Pivot.SLDPRT

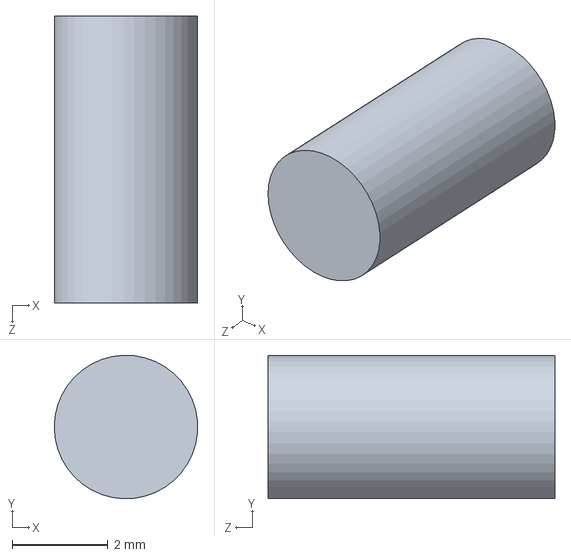
[picture p62: CAD file, 2018-02-15]
Solidworks Files/4.5 mm/Pivot.SLDPRT
3.00 x 3.00 x 6.00 mm
