CamilV/FEEG2001_QuadCopter/Solidworks Files/4.5 mm/sensor support.sldprt

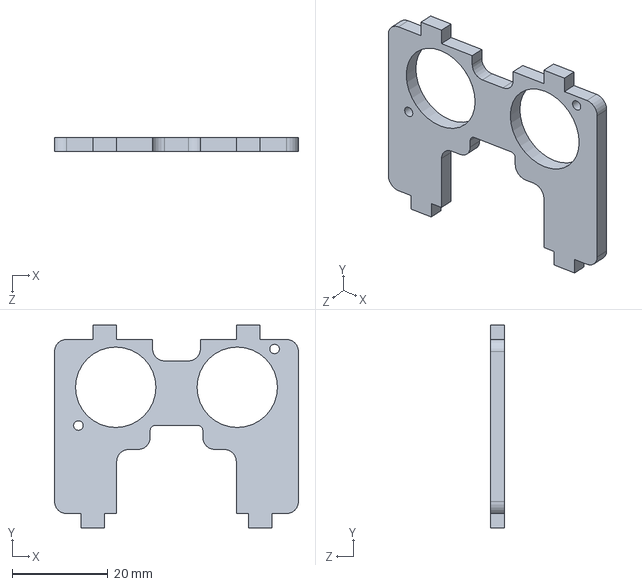
[picture p63: CAD file, 2018-02-12]
Solidworks Files/4.5 mm/sensor support.sldprt
51.0 x 42.4 x 3.00 mm
