CamilV/FEEG2001_QuadCopter/Solidworks Files/4.5 mm/AR610.SLDPRT

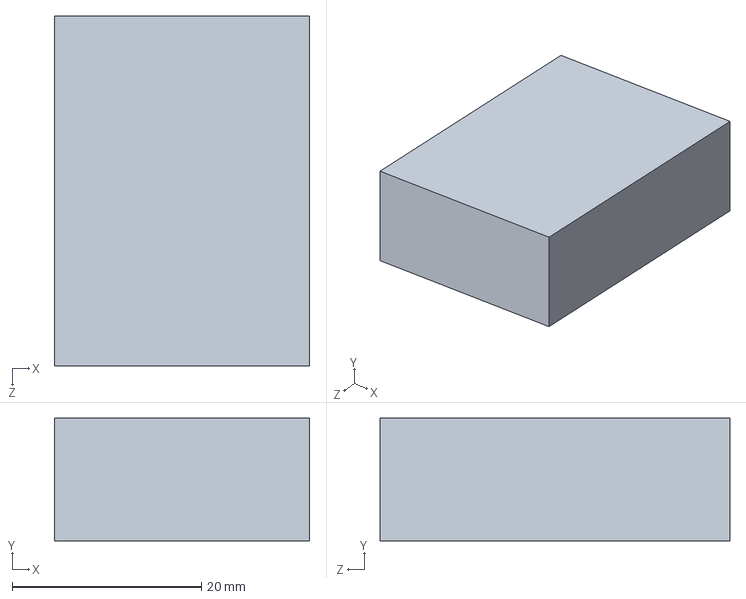
[picture p64: CAD file, 2018-02-07]
Solidworks Files/4.5 mm/AR610.SLDPRT
27.0 x 13.0 x 37.0 mm
