CamilV/FEEG2001_QuadCopter/Solidworks Files/4.5 mm/PDB_MATEK.SLDPRT

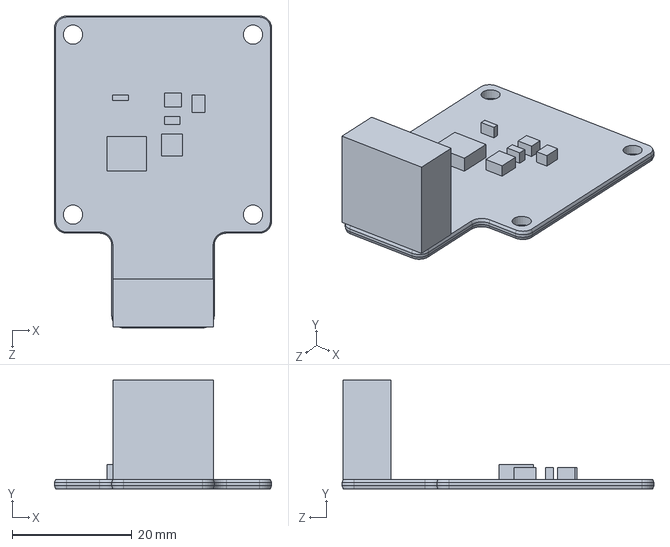
[picture p65: CAD file, 2018-02-07]
Solidworks Files/4.5 mm/PDB_MATEK.SLDPRT
36.2 x 18.2 x 52.0 mm
