CamilV/FEEG2001_QuadCopter/Solidworks Files/3 mm/arduino-and-shield.SLDPRT

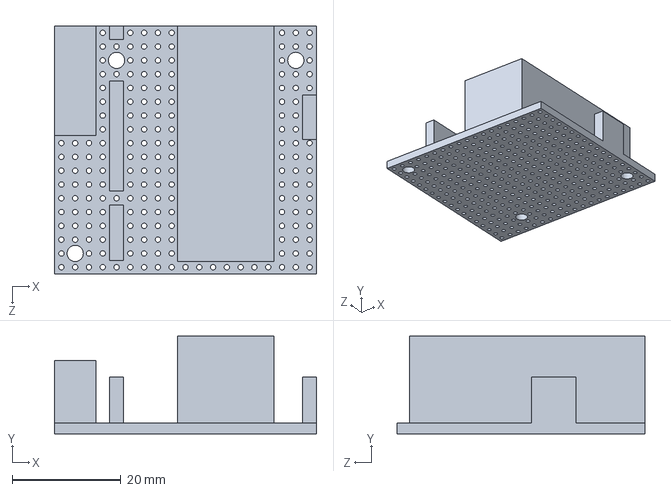
[picture p66: CAD file, 2018-02-07]
Solidworks Files/3 mm/arduino-and-shield.SLDPRT
48.3 x 18.0 x 45.7 mm
