CamilV/FEEG2001_QuadCopter/(list of files, cad)

Other CAD files:
Solidworks Files/3 mm/Assem1.SLDASM
Solidworks Files/4.5 mm/Assem1.SLDASM
Solidworks Files/3 mm/Servo Mini SG90/Servo.SLDPRT
Solidworks Files/4.5 mm/Servo Mini SG90/Servo.SLDPRT
SolidWorks Models/arduino-and-shield-1.SLDPRT
SolidWorks Models/Grabber/moving bottom.sldprt
Solidworks Files/4.5 mm/fixed bottom.sldprt
Solidworks Files/3 mm/fixed bottom.sldprt
Solidworks Files/4.5 mm/fixed top.sldprt
Solidworks Files/3 mm/fixed top.sldprt
Solidworks Files/4.5 mm/Battery.sldprt
Solidworks Files/4.5 mm/pin.sldprt
Solidworks Files/3 mm/Battery.sldprt
Solidworks Files/3 mm/pin.sldprt
Solidworks Files/4.5 mm/holder(just so the mates can exist).sldprt
Solidworks Files/4.5 mm/Coupler.sldprt
Solidworks Files/3 mm/holder(just so the mates can exist).sldprt
Solidworks Files/3 mm/Coupler.sldprt
Report - Week 5/Assem_Drone.SLDDRW
Report - Week 5/Drawings/Arms.SLDDRW
Report - Week 5/Drawings/Assem_Drone.SLDDRW
Report - Week 5/Drawings/Grabber open-closed.SLDDRW
SolidWorks Models/Grabber/Moving Bottm.sldprt
SolidWorks Models/Grabber/fixed bottom.sldprt
SolidWorks Models/Grabber/fixed top.sldprt
SolidWorks Models/Grabber/moving top.sldprt
SolidWorks Models/Main-Plate.SLDPRT
Solidworks Files/3 mm/AfroESC-30.SLDPRT
Solidworks Files/3 mm/Coupler - Copy.sldprt
Solidworks Files/3 mm/Naze32.SLDPRT
Solidworks Files/3 mm/Secondary plate.DXF
Solidworks Files/3 mm/SolidWorks Models/DYS SE2205.SLDPRT
Solidworks Files/3 mm/arduino-and-shield (1).SLDPRT
Solidworks Files/4.5 mm/AfroESC-30.SLDPRT
Solidworks Files/4.5 mm/Coupler - Copy.sldprt
Solidworks Files/4.5 mm/Naze32.SLDPRT
Solidworks Files/4.5 mm/SolidWorks Models/DYS SE2205.SLDPRT
Solidworks Files/4.5 mm/arduino-and-shield (1).SLDPRT
under-strut.sldprt
