CamilV/FEEG2001_QuadCopter/Code/Different sensor weights test.xlsx

Sheet: w=15
Column1 | Actual altitude | Smoothened altitude | Column4
118 | 5 | 0 | 600 | delay 86
244 | 5 | 1 | 535
344 | 5 | 2 | 532
443 | 5 | 2 | 534
542 | 5 | 3 | 529
660 | 5 | 3 | 531
759 | 5 | 3 | 531
859 | 5 | 4 | 526
957 | 5 | 4 | 528
1056 | 5 | 4 | 528
1156 | 5 | 4 | 528
1255 | 5 | 4 | 528
1354 | 5 | 4 | 528
1454 | 5 | 5 | 523
1553 | 5 | 5 | 525
1652 | 5 | 5 | 525
1752 | 5 | 5 | 525
1851 | 5 | 5 | 525
1950 | 5 | 5 | 525
2050 | 5 | 5 | 525
2149 | 5 | 5 | 525
2248 | 5 | 5 | 525
2348 | 5 | 5 | 525
2447 | 5 | 5 | 525
2548 | 38 | 10 | 500
2650 | 36 | 14 | 490
2751 | 42 | 18 | 478
2852 | 42 | 22 | 466
2954 | 44 | 25 | 459
3056 | 45 | 28 | 450
3158 | 46 | 31 | 441
3260 | 47 | 33 | 437
3361 | 49 | 35 | 431
3464 | 53 | 38 | 420
3566 | 56 | 41 | 411
3668 | 59 | 43 | 407
3775 | 62 | 46 | 396
3878 | 65 | 49 | 387
3981 | 67 | 52 | 378
4084 | 68 | 54 | 374
4203 | 68 | 56 | 368
4310 | 68 | 58 | 362
4412 | 67 | 59 | 361
4515 | 64 | 60 | 358
4618 | 59 | 60 | 360
4720 | 56 | 59 | 365
4823 | 51 | 58 | 368
4924 | 46 | 56 | 376
5025 | 42 | 54 | 382
5127 | 37 | 51 | 393
5228 | 32 | 49 | 397
5328 | 28 | 45 | 413
5429 | 24 | 42 | 420
5529 | 21 | 39 | 429
5629 | 19 | 36 | 438
5730 | 21 | 34 | 442
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
