CamilV/FEEG2001_QuadCopter/Testing/Sharp calibration and conversion.xlsx

Distance | Reading
10 | 705
20 | 410
30 | 316
40 | 258
50 | 225
60 | 210
70 | 192
80 | 183
90 | 176
100 | 168
110 | 163
120 | 157
