CamilV/FEEG2001_QuadCopter/Electronics/ArduinoBoard v2/base board v2_bb.pdf

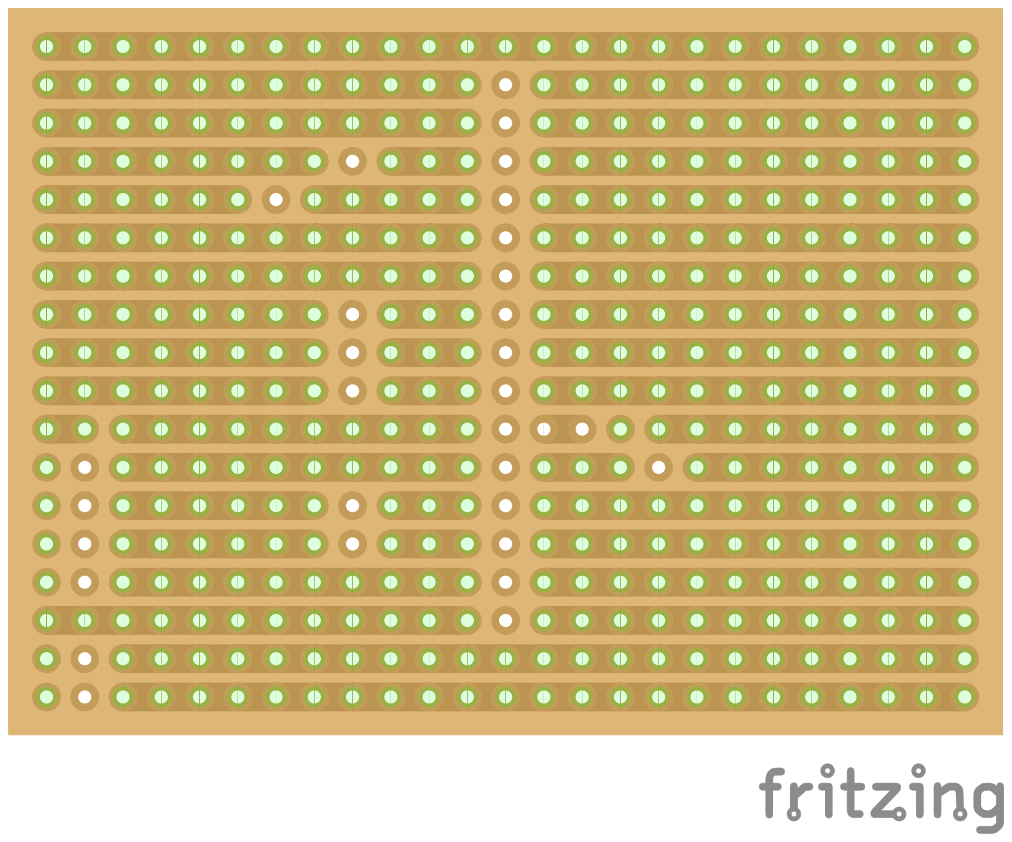
[picture p67: page 1]
