CamilV/FEEG2001_QuadCopter/(list of files, drawings)

Other design files:
Electronics/ArduinoBoard v1/base board.fzz
Electronics/ArduinoBoard v2/base board v2.fzz
Electronics/ArduinoBoard v3/base board v3.fzz
