CamilV/FEEG2001_QuadCopter/(commit log)

2018-02-07 updated the model of the arduino board
    [arduino and shield.SLDPRT]
2018-02-08 power and receiver pins added
    [base board v3.fzz]
2018-02-08 first couple of generic lines
    [DRONE-LOL.SLDPRT, arduino and shield.SLDPRT, base board v3.fzz]
2018-02-09 Telemetry SpreadSheet
    [Telemetry Data.xls]
2018-02-10 reading function
    [Assem_Drone.SLDASM, Main-Plate.SLDPRT, Secondary-plate.SLDPRT, Telemetry Data.xls, arduino-and-shield-1.SLDPRT, base board v3.fzz]
2018-02-12 Ultrasonic sensor
2018-02-12 Sensor supprt
    [Assem1.SLDASM, Coupler.sldprt, Horn Servo.SLDPRT, Moving Bottm.sldprt, SG60 Servo.SLDASM, Servo.SLDPRT, base board v3.fzz, fixed bottom.sldprt]
2018-02-12 updated Arduino PCB
    [Assem1.SLDASM, Assem_Drone.SLDASM, Coupler.sldprt, Moving Bottm.sldprt, base board v3.fzz, fixed bottom.sldprt, fixed top.sldprt, holder(just so the mates can exist).sldprt]
2018-02-12 board layout
2018-02-12 5 tooth grabber
    [Assem1.SLDASM, Moving Bottm.sldprt, fixed bottom.sldprt, fixed top.sldprt, holder(just so the mates can exist).sldprt, moving top.sldprt]
2018-02-13 Bluetooth telemetry working
    [Telemetry Data.xls]
2018-02-14 telemetry delay of 500 ms added
    [Coupler-Copy.sldprt]
2018-02-15 SW model
    [AR610.SLDPRT, AfroESC 30.SLDPRT, AfroESC-30.SLDPRT, Arduino Uno.SLDPRT, Assem1.SLDASM, Assem_Drone.SLDASM, Battery.sldprt, Copy of Part3.sldprt]
2018-02-16 2 flying modes(with and without payload)
    [Assem_Drone.SLDASM, Part3.sldprt, Part4.sldprt, pin.sldprt, triangular strut.sldprt, under strut.sldprt]
2018-02-16 Complete SW model
    [Assem_Drone.SLDASM, Battery.sldprt, Part4.sldprt, under strut.sldprt]
2018-02-16 weight shave
    [Assem_Drone.SLDASM, under strut.sldprt]
2018-02-17 tested the US sensor
    found a library that reads the sensor automatically
2018-02-19 Create Report – Week 5
2018-02-21 Average Altitude reading
    [Assem_Drone.SLDASM, DYS-SE2205.SLDPRT]
2018-02-22 mass, cost, assembly drawing
    [Assem_Drone.SLDDRW, Cost quadcopter.ods, Mass quadcopter.ods]
2018-02-22 cost changes
    [Cost quadcopter.ods]
2018-02-22 updated mass and model
    [Assem_Drone.SLDASM, Long Side.sldprt, Main Plate.SLDPRT, Mass quadcopter.ods, Part4.sldprt, Secondary plate.SLDPRT, Short Side.sldprt, triangular strut.sldprt]
2018-02-24 part drawings
    [Arms.SLDDRW, Assem_Drone.SLDDRW, Grabber open-closed.SLDDRW]
2018-02-25 some dimensions where off
    [Assem_Drone.SLDASM, Long Side.sldprt, Main Plate.SLDPRT]
2018-02-28 trying to make it stiffer
    changed the puzzle pattern of the sides and added some holes for pins on the plate that supports the electronics
    [Assem_Drone.SLDASM, Long Side.sldprt, Main Plate.SLDPRT, Secondary plate.SLDPRT, Short Side.sldprt]
2018-03-01 Data filtering algorithm implemented
    tried to do some data filtering for a more accurate altitude reading. Not yet to fly with this algorithm in autopilot!
2018-03-03 changes to the hinges to accomodate the mounting holes
    [Assem_Drone.SLDASM, Copy of Part3.sldprt, Main Plate.SLDPRT, Part3.sldprt, Part4.sldprt, under strut.sldprt]
2018-03-05 lates model
    [Assem_Drone.SLDASM]
2018-03-05 grabber 6 tooth
    [Assem_Drone.SLDASM, Moving Bottm.sldprt, fixed bottom.sldprt, fixed top.sldprt, moving top.sldprt]
2018-03-08 3rd strut
    [AR610.SLDPRT, AfroESC 30.SLDPRT, AfroESC-30.SLDPRT, Arduino Uno.SLDPRT, Assem1.SLDASM, Assem_Drone.SLDASM, Back Side.sldprt, Battery.sldprt]
2018-03-08 model almost done
    [Assem_Drone.SLDASM, Back Side.sldprt, Long Side.sldprt, Part4.sldprt, Short Side.sldprt, pin short.sldprt, under strut.sldprt]
2018-03-08 added some fillets
    [Assem_Drone.SLDASM, Back Side.sldprt, Main Plate.SLDPRT, under strut.sldprt]
2018-03-08 complete code. constants to be adjusted
    [Assem_Drone.SLDASM, Telemetry Data.xls]
2018-03-11 telemetry file changed with graphs
    [Telemetry Data.xls]
2018-03-12 telemetry changes and some code
    [Telemetry Data.xls]
2018-03-12 sensor weights tests
    [Different sensor weights test.xlsx]
2018-03-21 anti-windup algorithm added. needs a lot of testing. might not work
    [QuadCopter.h, defines.h, flying.cpp]
2018-04-19 first few pages of the report
    [Assem_Drone.SLDASM, base board v3.fzz, under strut.sldprt]
2018-04-21 written part of the report
    [Different sensor weights test.xlsx]
2018-04-24 constants change
    [Telemetry Data.xls]
2018-04-25 code works
    [under-strut v2.sldprt, under-strut.sldprt]
2018-04-30 code tweaks and telemetry from today
    [Telemetry Data.xls]
2018-04-30 code tweaks
    [Telemetry Data.xls]
2018-05-06 many changes, cant really remember what i've changed
    [Assem_Drone.SLDASM, max support.sldprt]
2018-05-06 model change to 6 mm
    [Assem_Drone.SLDASM, Back Side.sldprt, Long Side.sldprt, Main Plate.SLDPRT, Short Side.sldprt, triangular strut.sldprt, under strut.sldprt, under-strut v2.sldprt]
2018-05-09 after the test
    [Assem_Drone.SLDASM, BTFL_cli_20180509_130857.txt, Back Side.DXF, Long Side.DXF, Main Plate.DXF, Main Plate.SLDPRT, Part4.sldprt, Short Side.DXF]
2018-05-13 last commit
    [Telemetry Data.xls]
2018-05-14 final telemetry
    [Telemetry Data.xls]
